jaimealbapastor/autonomous-gardener/Reports/Jaime/session03.md

***[<< previous session](session02.md) | [next session >>](session04.md)***

# Session 3

This session was dedicated to the modeling of the suspension pieces. My intention was to complete two or three, but it took longer than expected.

Since the wide bearing was delivered, I adjusted some measurements in Fusion360.
This one will be placed in the center of the differential.  
However, we are currently awaiting the delivery of the remaining bearings so that I can precisely measure them.
Then I'll 3D print these parts.

## Piece S1 (Suspension 1) - The differential

Here's how the differential currently looks like :

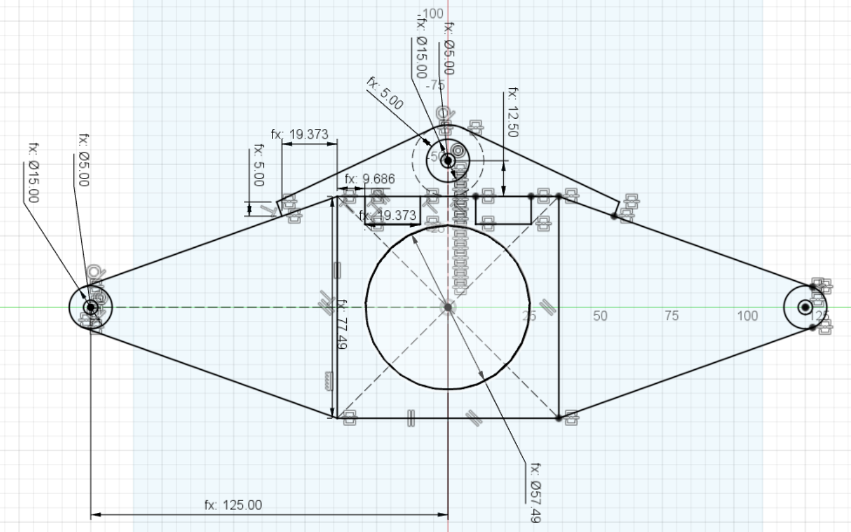
[picture p53: Documentation/Images/differential_sketch2.png]
differential_sketch2
||
|:---:|
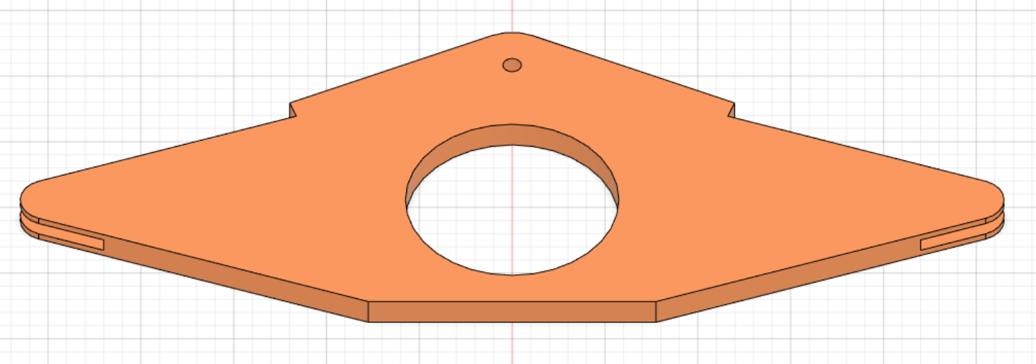
[picture p54: Documentation/Images/differential_3D_model_3.png]
3D_model_3
||
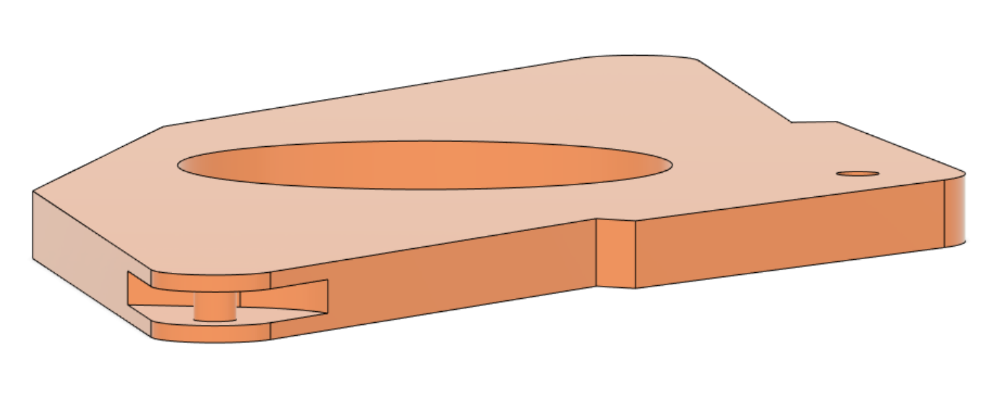
[picture p55: Documentation/Images/differential_3D_model_2.png]
3D_model_2
||

## Piece S2 (Suspension 2)

The branch linking the differential to the primary pivot is the next component to model. It will be named S2. As you can see, this is how it would look like :

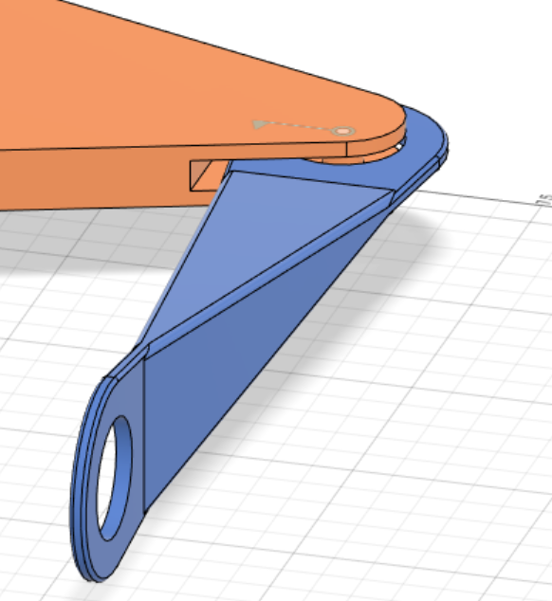
[picture p56: Documentation/Images/branch_assembly1.png]
branch_assembly1
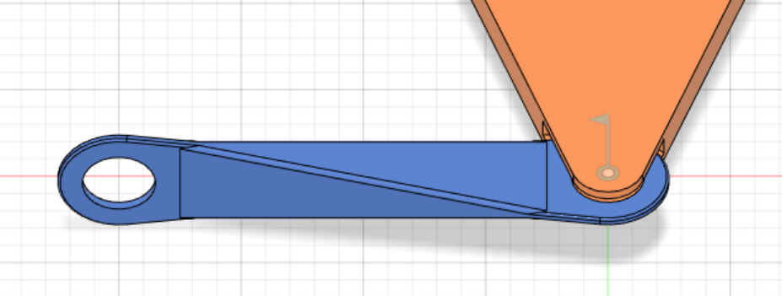
[picture p57: Documentation/Images/branch_assembly2.png]
branch_assembly2
|||
|:---:|:---:|
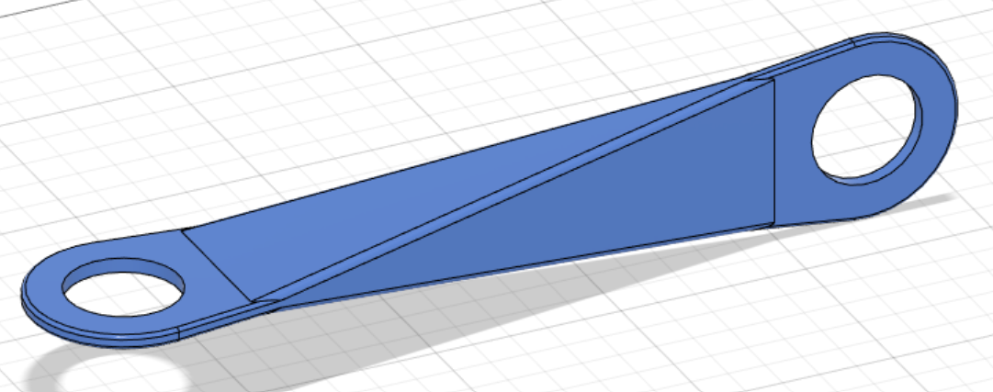
[picture p58: Documentation/Images/branch_model1.png]
branch_model1
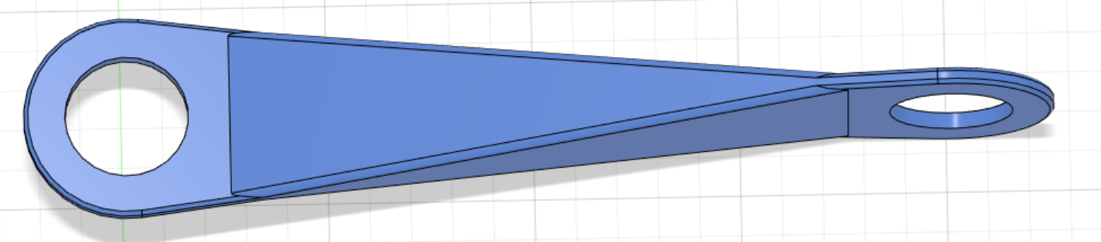
[picture p59: Documentation/Images/branch_model2.png]
branch_model2
|||

### Modeling

I initially tried modeling this component exclusively with extrusions. However, due to its peculiar geometry, it proved to be an inadequate solution.  

But after asking for advice, it ocurred to me that I could cut triangular shapes off the sides of a extruded rectangle.

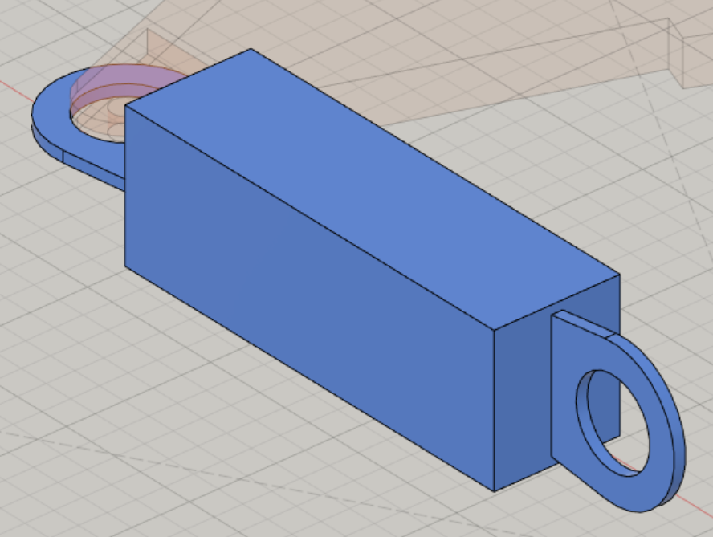
[picture p60: Documentation/Images/branch_model3.png]
branch_model3
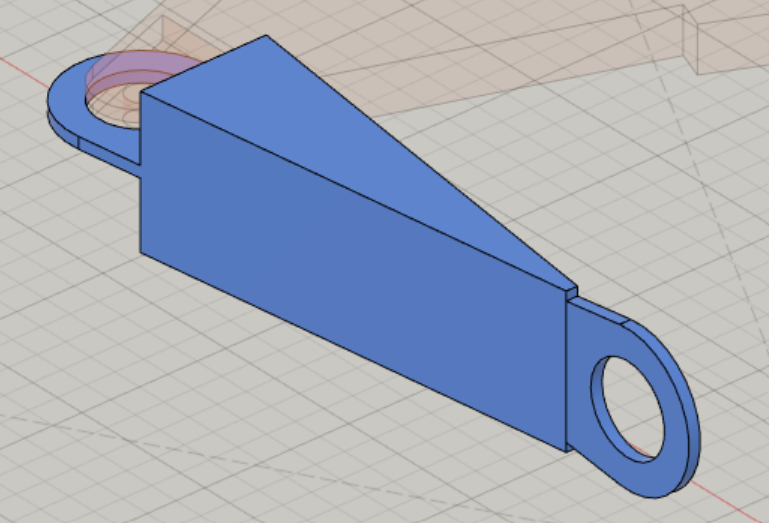
[picture p61: Documentation/Images/branch_model4.png]
branch_model4
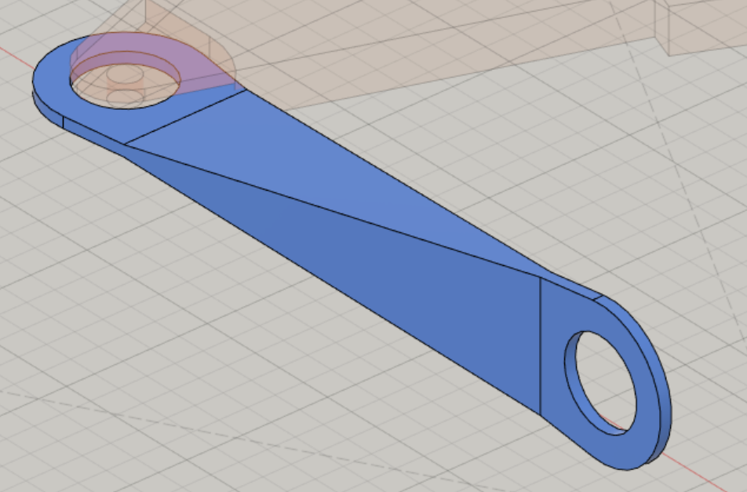
[picture p62: Documentation/Images/branch_model5.png]
branch_model5
||||
|:---:|:---:|:---:|

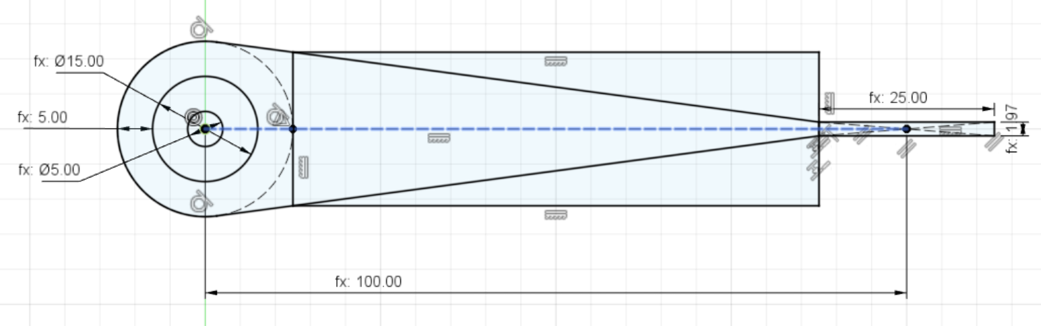
[picture p63: Documentation/Images/branch_sketch1.png]
branch_assembly1
||
|:---:|

***[<< previous session](session02.md) | [next session >>](session04.md)***
