jaimealbapastor/autonomous-gardener/Reports/Jaime/session04.md

***[<< previous session](session03.md) | [next session >>](session05.md)***

# Session 4

During this session I received the pipes and bearings for the differential.  
Here are the specifications:

|Pipes||
|:---:|:---:|
|External diameter|12 mm|
|Width|1 mm|

|Small Bearings|[Amazon.fr](https://www.amazon.fr/Roulements-Bearings-Skateboard-Longboard-Waveboard/dp/B07S3SZZST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)|
|:---:|:---:|
|External diameter|22 mm|
|Internal diameter|8 mm|
|Height|7 mm|

|Big Bearing||
|:---:|:---:|
|External diameter|57.5 mm|
|Internal diameter|50 mm|
|Height|7 mm|

Having the specifications of these two components, I updated the variables of the differential.

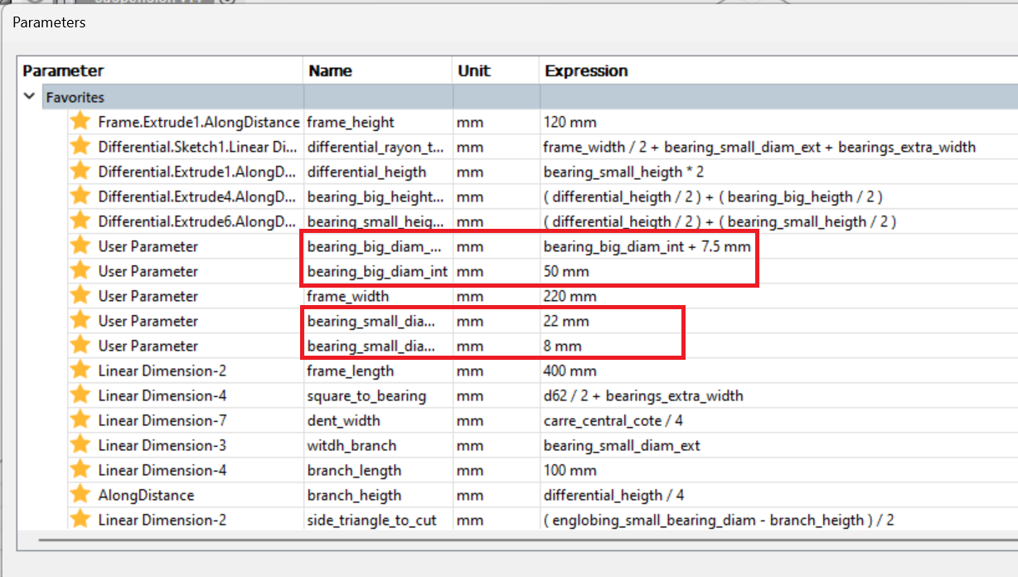
[picture p64: Documentation/Images/variables.png]
variables


I also made some little modifications to fit the bearings.

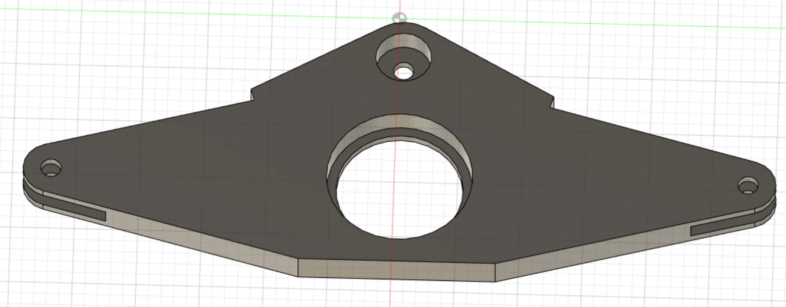
[picture p65: Documentation/Images/differential_3D_model_4.png]
differential_3D_model_4

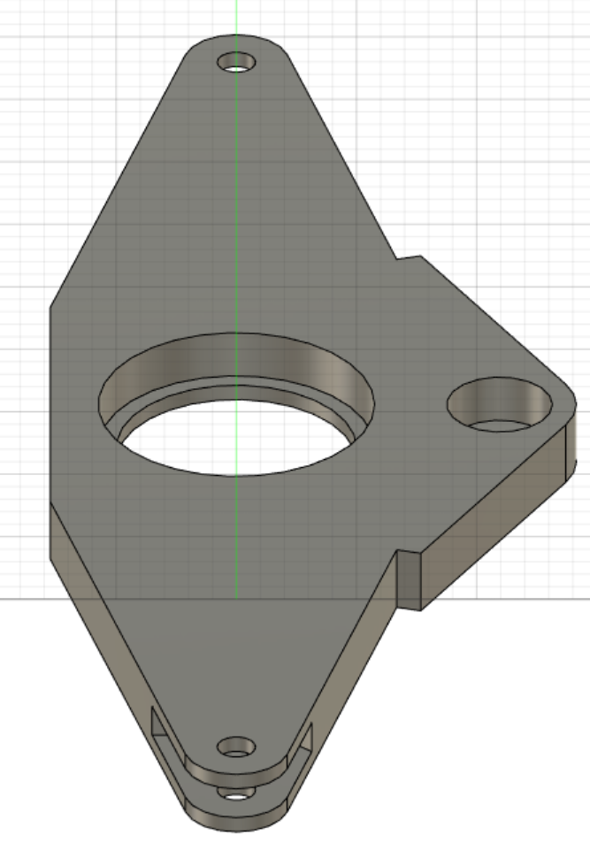
[picture p66: Documentation/Images/differential_3D_model_5.png]
differential_3D_model_5


Plus, in order to optimize the [piece S2](./session3.md/#piece-s2-suspension-2), I remodeled it using the pipes.

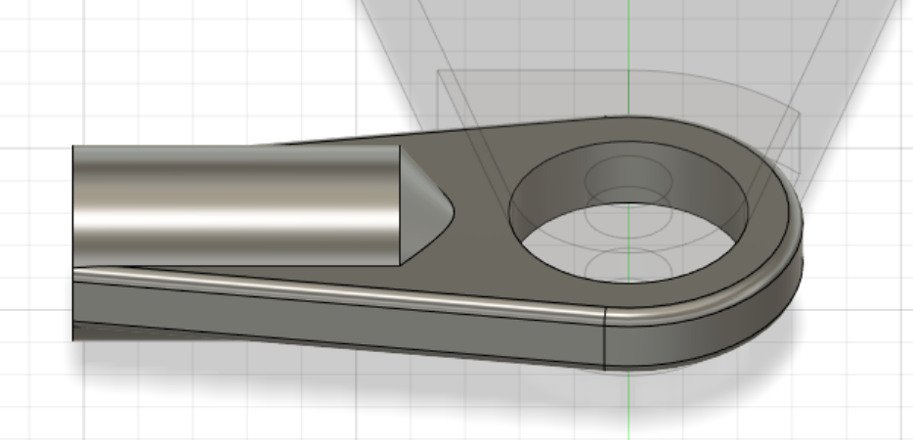
[picture p67: Documentation/Images/S2_1.png]
S2_1

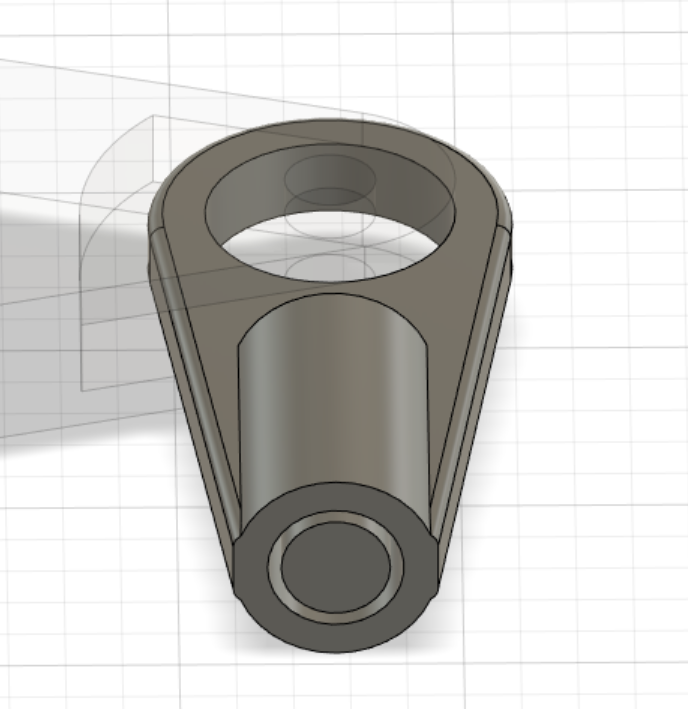
[picture p68: Documentation/Images/S2_2.png]
S2_2

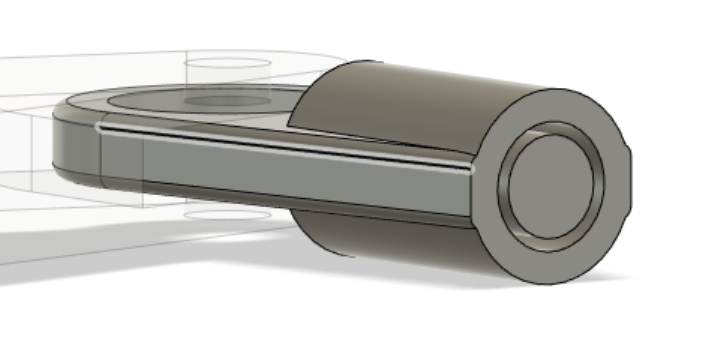
[picture p69: Documentation/Images/S2_3.png]
S2_3


## Fabrication

In order to 3D-print the differential, I sliced the 3D model and exported the G-code.  
However, after a quick discussion with M.Masson, we decided that making it out of wood would be preferable in case we needed to make minor changes to the piece.  

To make it out of wood, I'll laser-cut multiple layers and glue them all together. As a result, the differential will be both rigid and light.  
So I began by exporting the Fusion360 sketch to create the svg file, but the exported file is not optimized for editing in Inkscape.  

As a result, my next session will be devoted to:  

1. Recreate the sketch so that it can be exported and edited as an svg file.  
2. 3D-print the piece S2

---
Note  
[*S'inscrire au GDR*](https://www.gdr-robotique.org/inscription/)

***[<< previous session](session03.md) | [next session >>](session05.md)***
