jaimealbapastor/autonomous-gardener/Reports/Jaime/session06.md

***[<< previous session](session05.md) | [next session >>](session07.md)***

# Session 6

## Differential production

I created the initial version of the differential during the brief session we had with M. Masson at the FabLab. But because of a measurement error, I had to start over throughout this session.

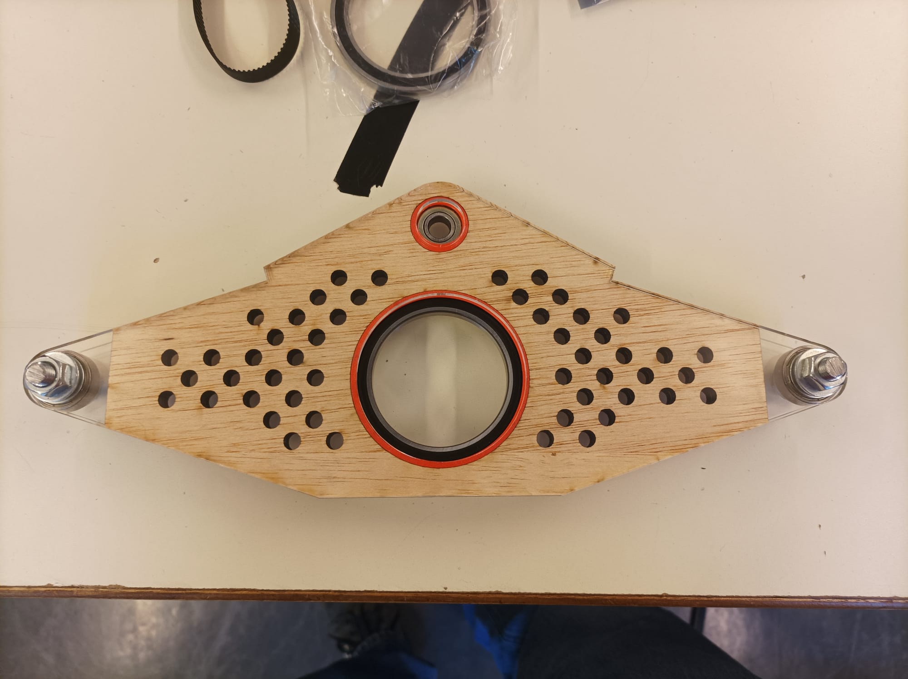
[picture p79: Documentation/Images/differential_built_2.jpg]


I started by cutting the inner layers of the differential, which are made out of wood, with the laser cutter. These two 5mm layers, which make up a total of 10mm, encircle the middle bearings and attenuate minor vibrations.

Then, the rigidity of the differential will then be handled by the plexiglass outer layers.

The bearings can rotate without encountering any resistance through 3D printed rings that separate the bearings in the wood layer from the plexiglass.

Finally, I sawed a threaded tube that holds the bearing and layers of plexiglass together. Rings are also mounted to the bearings to reduce friction with the plexiglass layers.

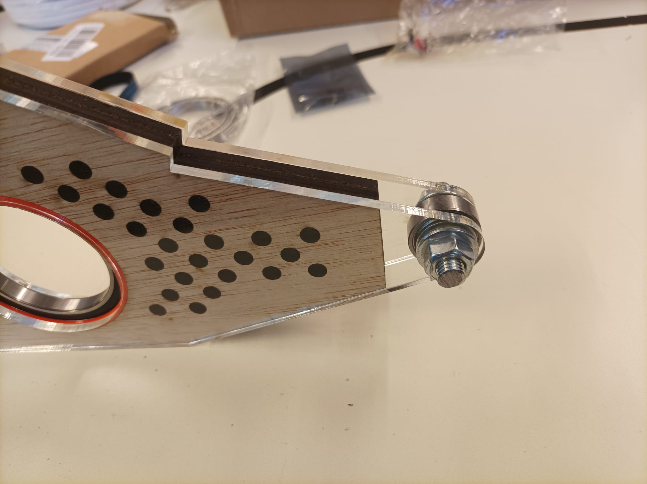
[picture p80: Documentation/Images/differential_built_1.jpg]


The tube joint below will be supported by the bearings on the extremities.  
Nevertheless, the printed version's diameter was too small for our tube. Therefore, I've started a 3D impression for a different version that hopefully meets the requirements.

|||
|:---:|:---:|

## Main pivot

I've started modelling the main pivot in order to add wheels as soon as possible.

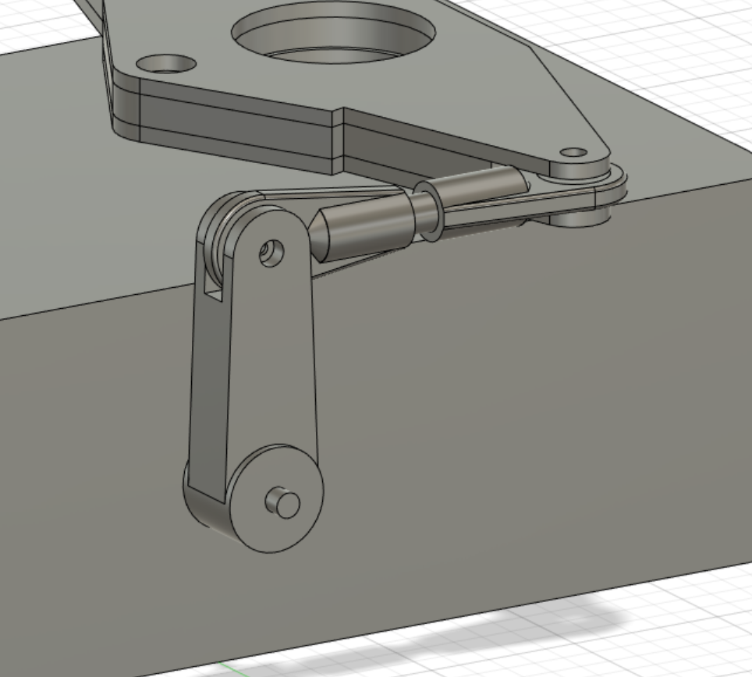
[picture p81: Documentation/Images/main_pivot_1.png]
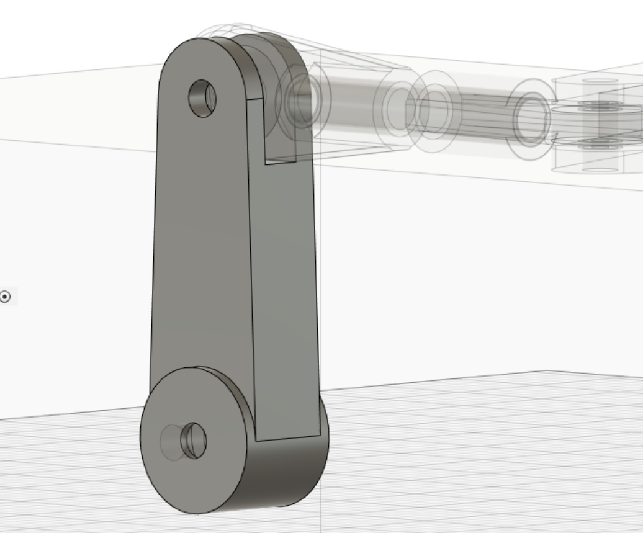
[picture p82: Documentation/Images/main_pivot_2.png]
|||
|:---:|:---:|

This piece wont be using metal tubes since the distance is pretty short. However, in the case where the robot was made bigger, I would redesign the main pivot.

Inside the piece will be located two bearings as such:



However, I'm still considering whether to put them inside or make them visible so that we may remove them whenever we want.  

Finally, I am facing difficulties extruding the other tube joints. I'm trying to make them angled like the mars rover, but if it takes too long, I might just make them straight.

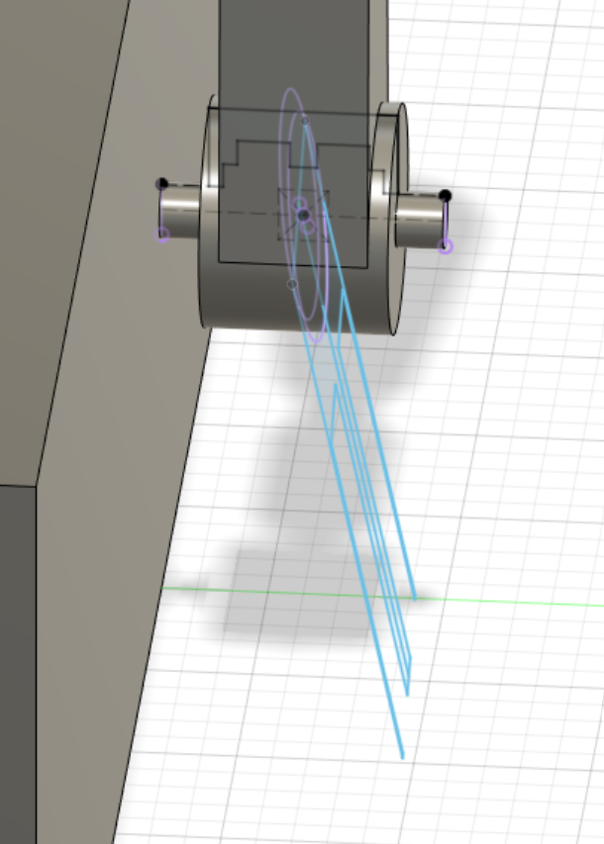
[picture p83: Documentation/Images/main_pivot_4.png]


***[<< previous session](session05.md) | [next session >>](session07.md)***
