jaimealbapastor/autonomous-gardener/Reports/Jaime/session07.md

***[<< previous session](session06.md) | [next session >>](session08.md)***

# Session 7

## Differential

During this session I finished the building of the differential.

The new version of the 3d printed joints that will connect to the tubes fit perfectly.

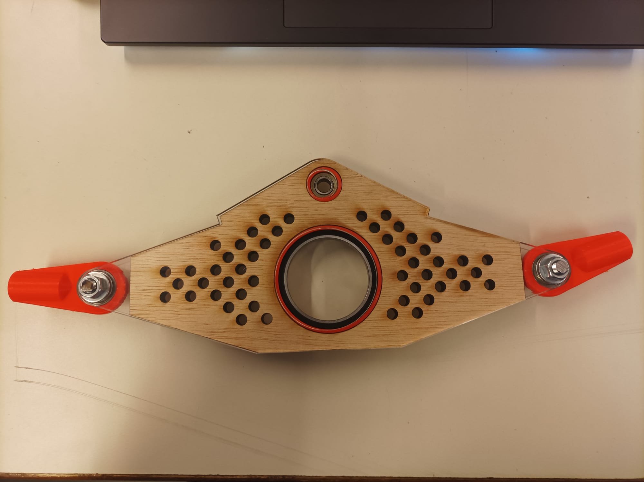
[picture p84: Documentation/Images/differential_built_3.jpg]
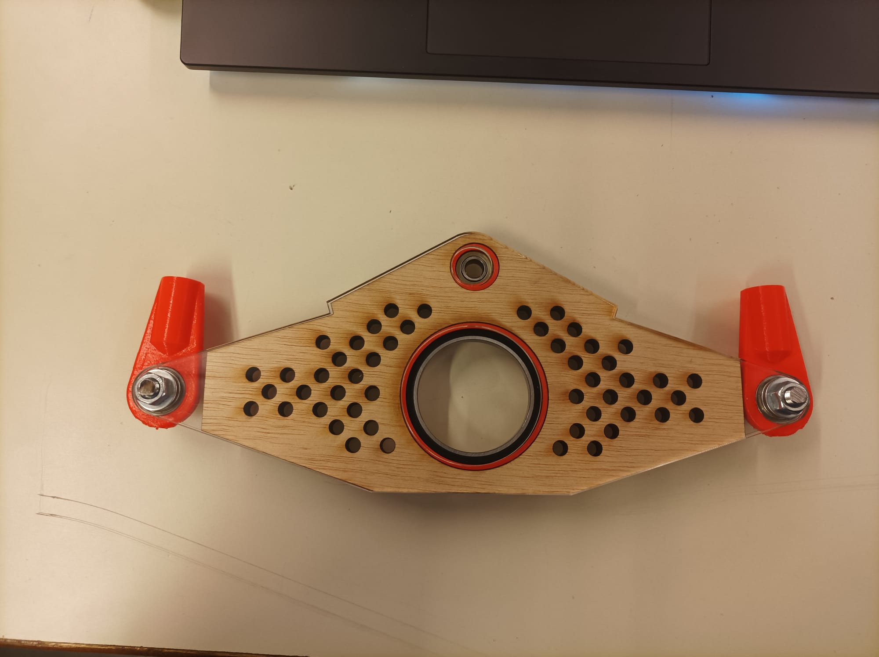
[picture p85: Documentation/Images/differential_built_4.jpg]
|||
|:---:|:---:|

Additionally, I drilled several holes so that I could add screws and keep the wood layer in place.

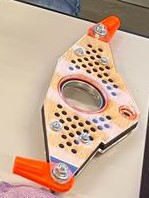
[picture p86: Documentation/Images/differential_built_5.jpg]


I discovered a minor problem: the bearings inside the wood layer are a little loose. So I'll just print new 3D rings a bit wider.

## Main pivot

I continued modeling the main pivot.  

The component will have to withstand significant angular forces coming from the tubes to the vertical axe. So, in order to increase the distribution of the momentum, I modelled a circular shape.

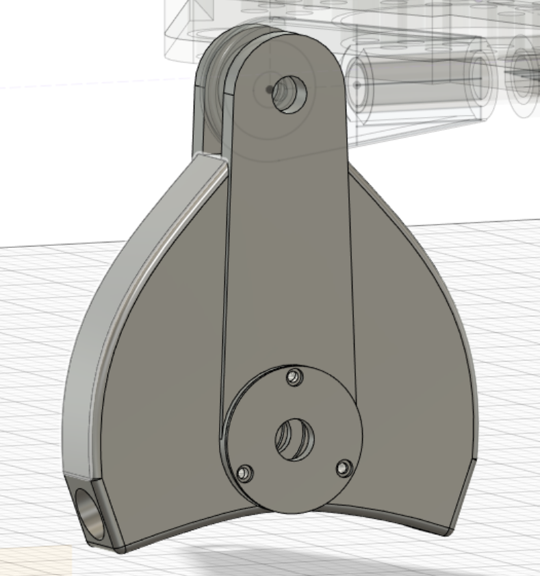
[picture p87: Documentation/Images/main_pivot_5.png]
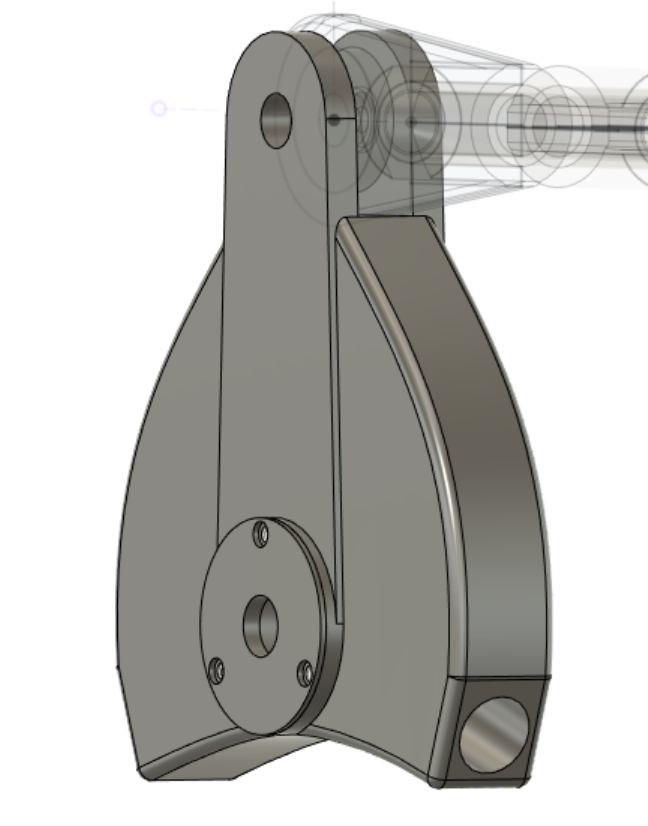
[picture p88: Documentation/Images/main_pivot_6.png]
|||
|:---:|:---:|

However, I believe that applying the Trellis approach would help to reduce the mass. I'll investigate that over the weekend.  

Finally, I placed two lids to the piece's sides so that the bearings can be taken out if necessary.  

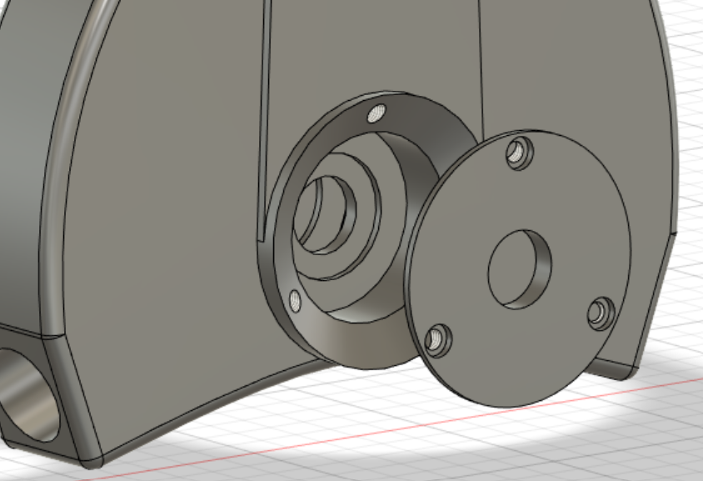
[picture p89: Documentation/Images/main_pivot_7.png]
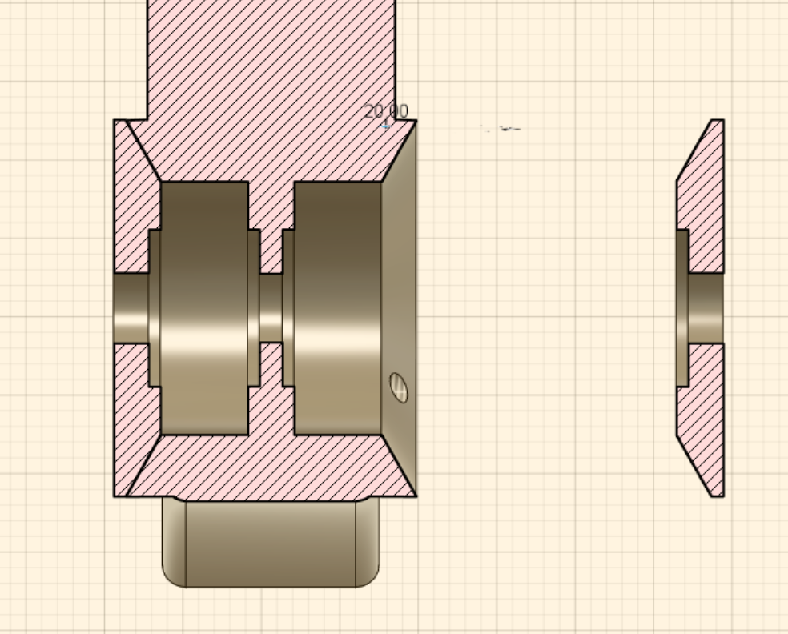
[picture p90: Documentation/Images/main_pivot_8.png]
|||
|:---:|:---:|

***[<< previous session](session06.md) | [next session >>](session08.md)***
