jaimealbapastor/autonomous-gardener/Reports/Jaime/session09.md

***[<< previous session](session08.md) | [next session >>](session10.md)***

# Session 9

I first started this session by taking the finished 3d impression of the main pivot.  
I had to take away all the supports which take a long time.

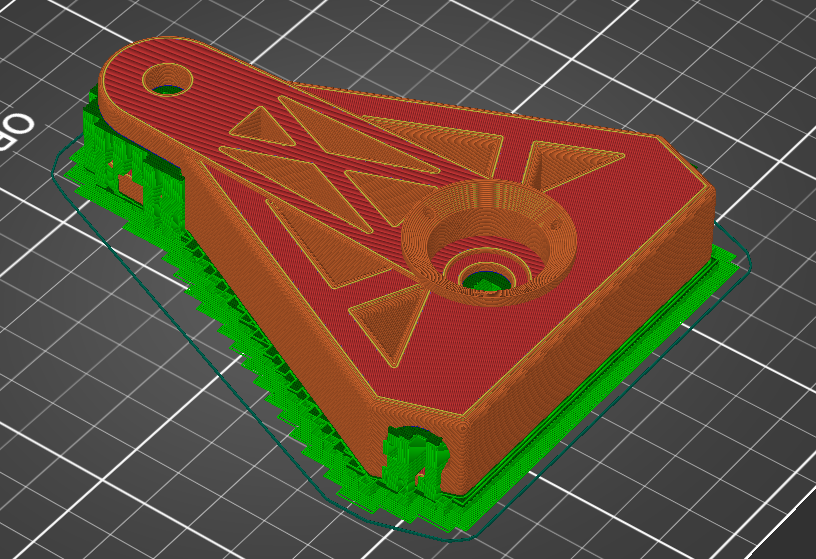
[picture p91: Documentation/Images/main_pivot_14.png]

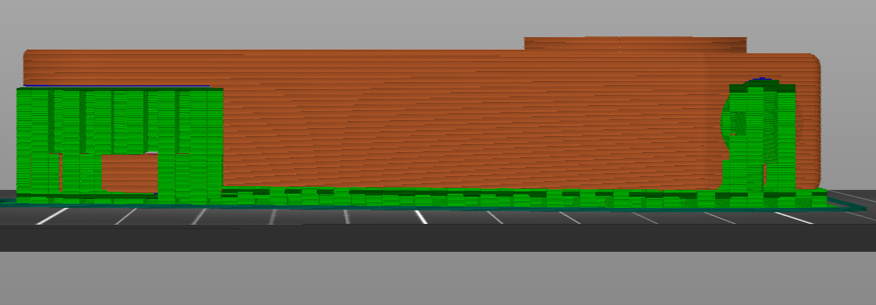
[picture p92: Documentation/Images/main_pivot_15.png]


Then I softened the borders and faces.

I had to make the thread for the screws in order to fix the bearings inside. This was a really slow and focused activity.

Brice assisted me in inserting the tube through the main axe after this was finished and the bearings were secured internally. We used a heavy hammer to smash our way in.

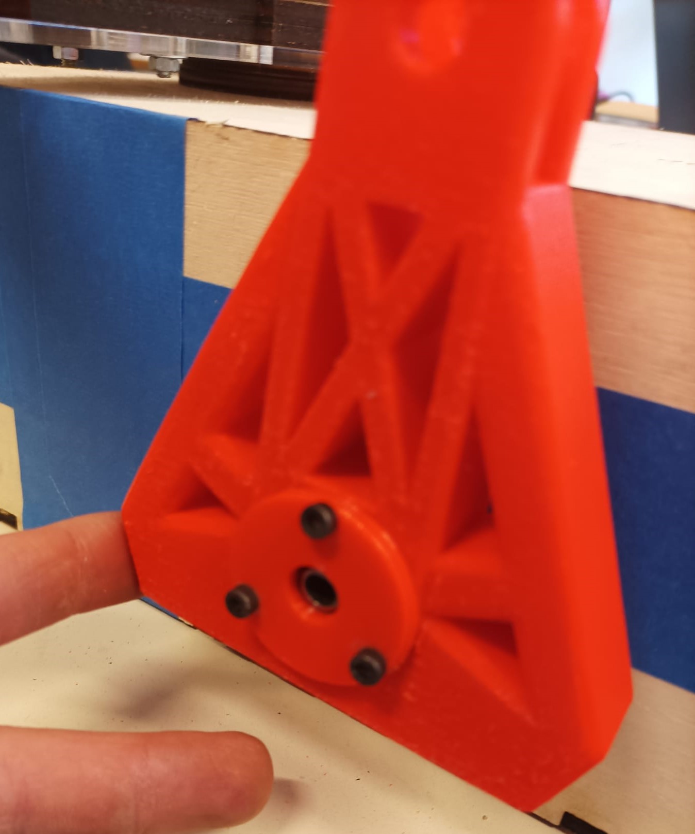
[picture p93: Documentation/Images/main_pivot_impression_1.jpg]

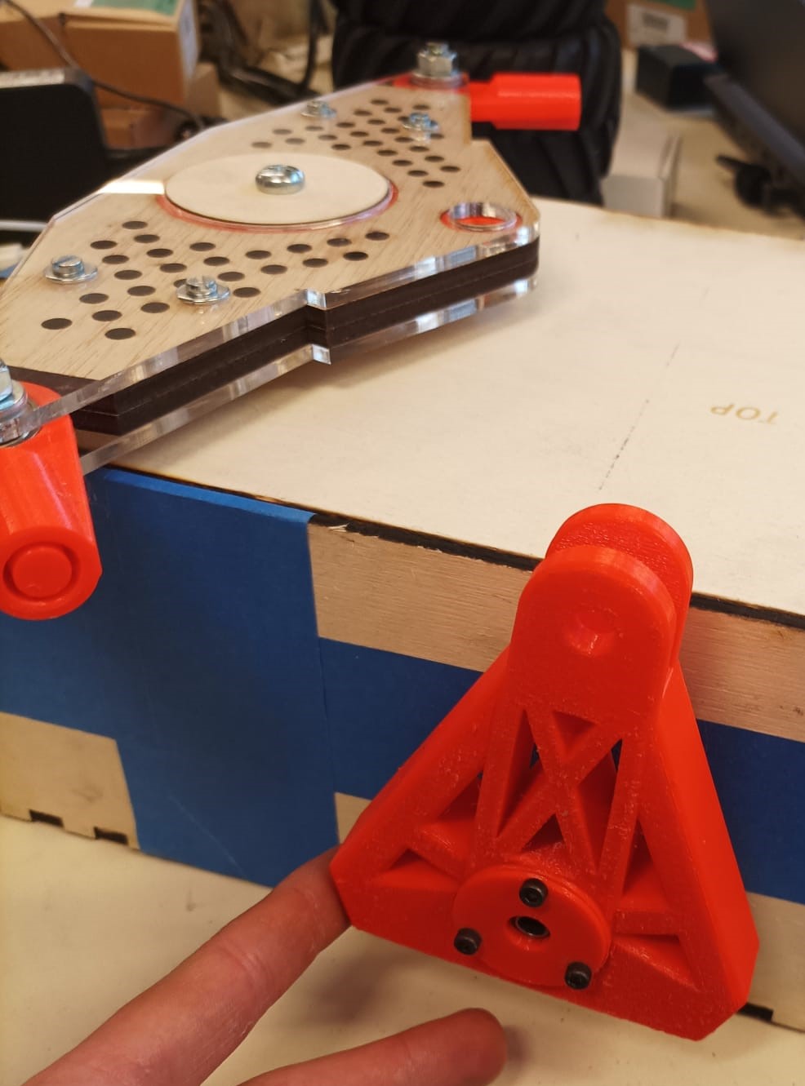
[picture p94: Documentation/Images/main_pivot_impression_2.jpg]
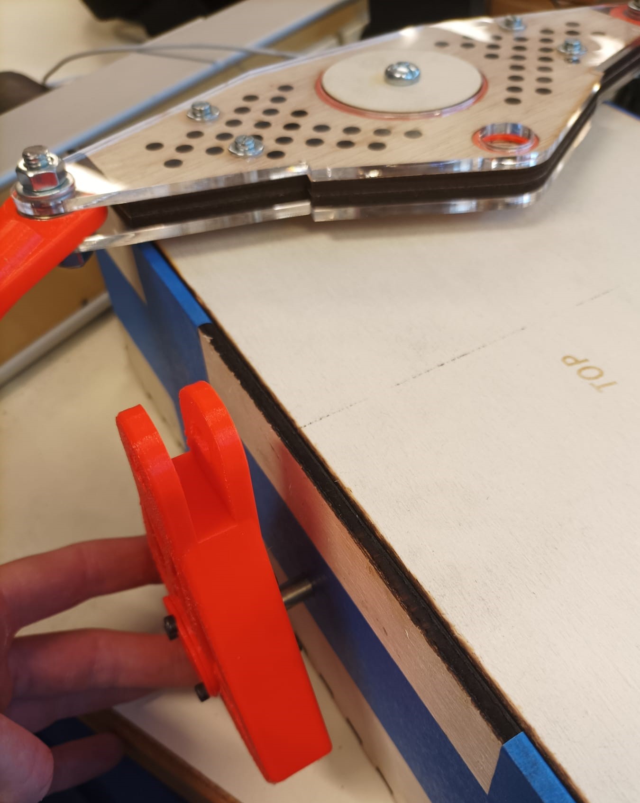
[picture p95: Documentation/Images/main_pivot_impression_3.jpg]
|||
|:---:|:---:|

By the end of the session, I noticed that the tubes connecting the wheels weren't the right size. I therefore had to even them out. They now fit flawlessly.

Brice and I also talked about how to attach the differential to the frame. We made the decision to laser cut the wood into circular shapes to encircle the central bearing. By doing so, we prevent friction.

In order to prevent the frame from collapsing, I additionally applied scotch tape to it.

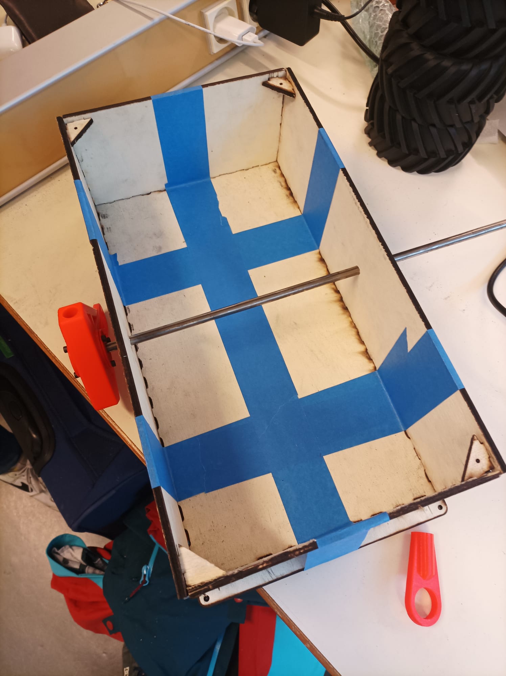
[picture p96: Documentation/Images/frame1.jpg]


***[<< previous session](session08.md) | [next session >>](session10.md)***
