jaimealbapastor/autonomous-gardener/Reports/Jaime/session13.md

***[<< previous session](session12.md) | [next session >>](session14.md)***

# Session 13

Powering the motors and verifying the `C++` code should be the next steps in the project.
But since the drivers weren't there yet, I carried on enhancing the mechanical structure.

I took the 3D printed parts out of the printer and spent the first hour carefully removing the supports.  

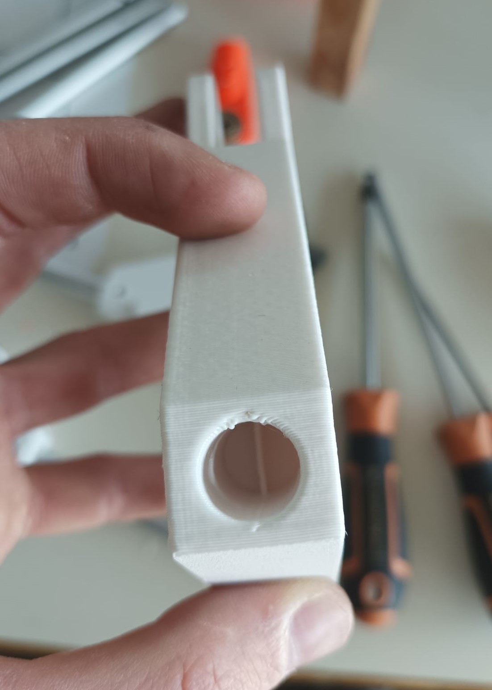
[picture p108: Documentation/Images/piece1.jpg]
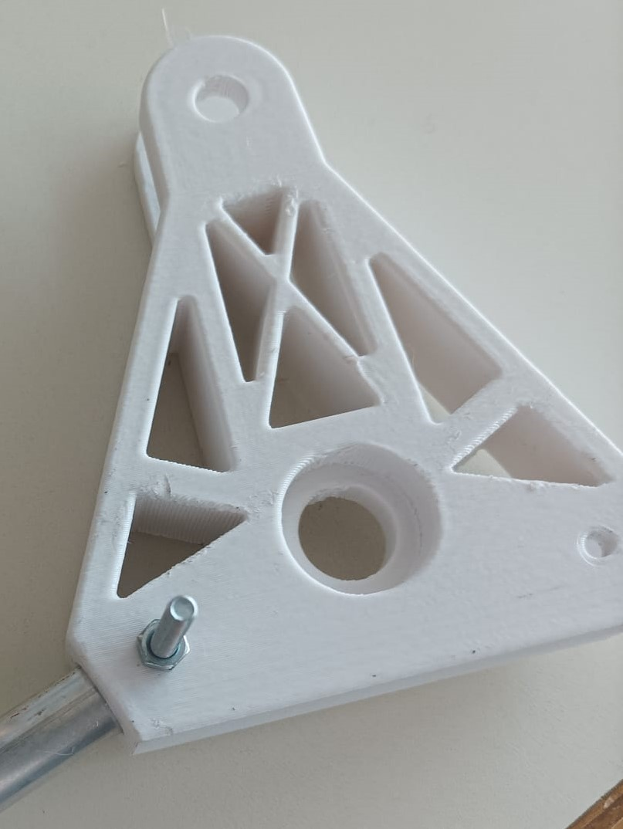
[picture p109: Documentation/Images/piece2.jpg]
|||
|:---:|:---:|

To make the components fit together in this new design, I must cut a thin stripe.

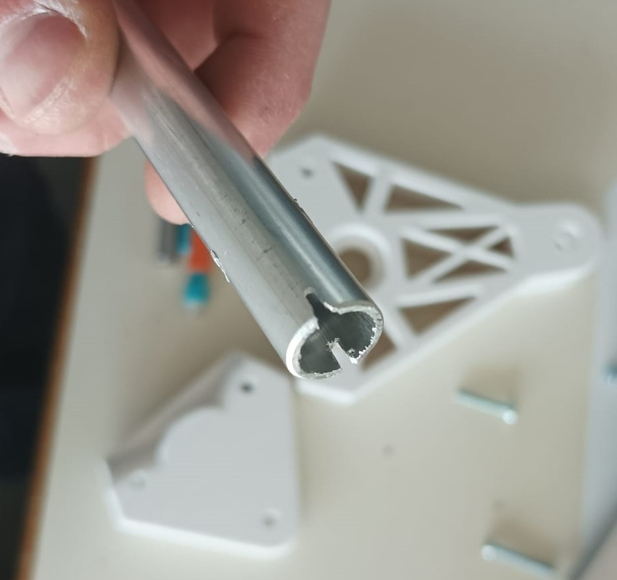
[picture p110: Documentation/Images/piece4.jpg]
  

I achieved what I was aiming for by giving the tubes almost no freedom of movement.  
Also, since the 3D printed parts already have holes, drilling the tubes is so much faster and more accurate.

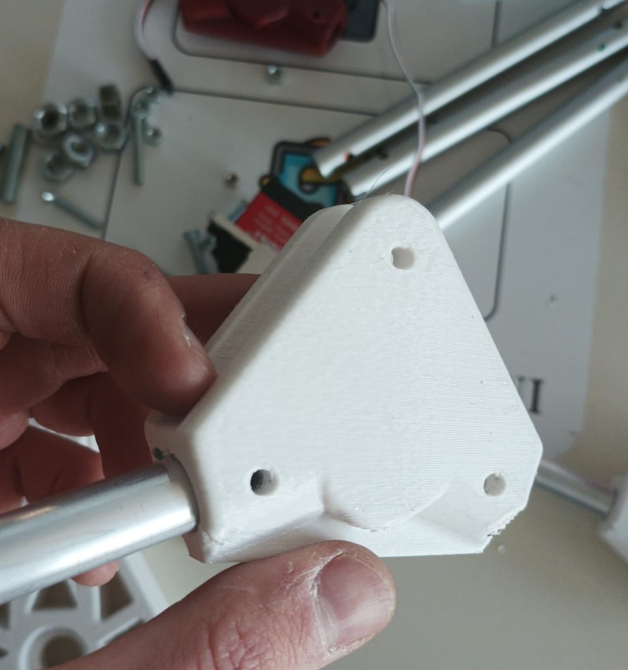
[picture p111: Documentation/Images/piece3.jpg]
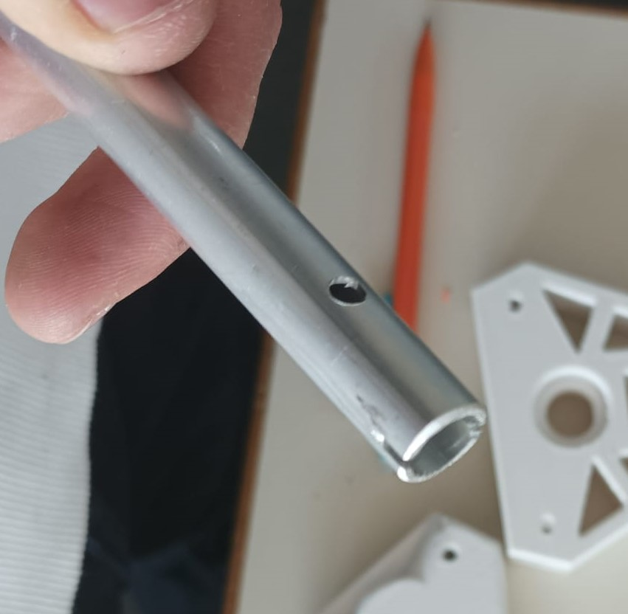
[picture p112: Documentation/Images/piece5.jpg]
|||
|:---:|:---:|

I prioritized the precision over the speed, so I only had time to finish one side of the structure. Due to the lengthy and slow process, this session report has less information.

Nonetheless, this work should greatly improve fluidity and decrease future crashes.  

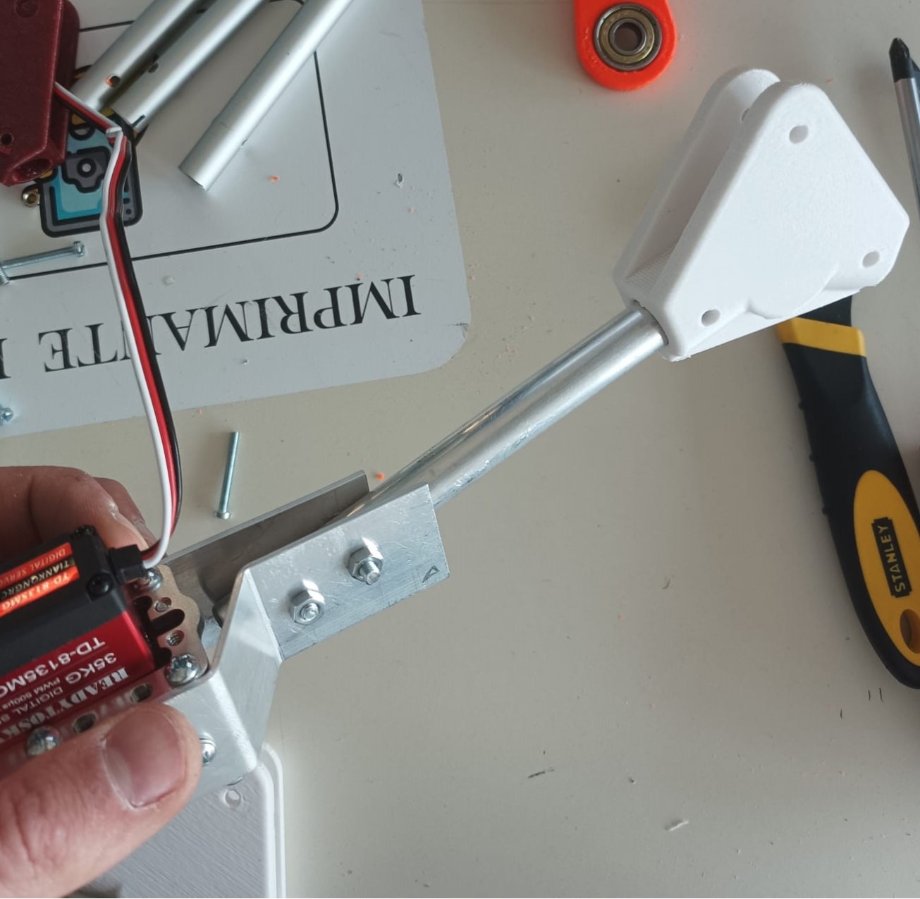
[picture p113: Documentation/Images/piece6.jpg]
  

***[<< previous session](session12.md) | [next session >>](session14.md)***
