jaimealbapastor/autonomous-gardener/Reports/Jaime/rapport_info.md

premier jour

idéation du code et angles roues

deuxieme jour

probleme ssh windows
https://unix.stackexchange.com/questions/602518/ssh-connection-client-loop-send-disconnect-broken-pipe-or-connection-reset

sur virtualbox ça marche via serial

connexion à wifi sur tel (2.4GHz)
puis connexion ssh sur windows

`ifconfig` pour voir les addresses IP

pour le moment serial mais on passera surement à I2C pour connecter le lidar à la jetson nano directement

communication python et arduino
https://www.instructables.com/Arduino-Python-Communication-via-USB/
