jaimealbapastor/autonomous-gardener/Reports/Brice/Séance 6.md

## Rapports de séance Brice Mabille

- 06/12/2022 : Setup du projet GitHub partagé

# Séance 6:

In this session, I started by 3D printing the Auger and the gear system.

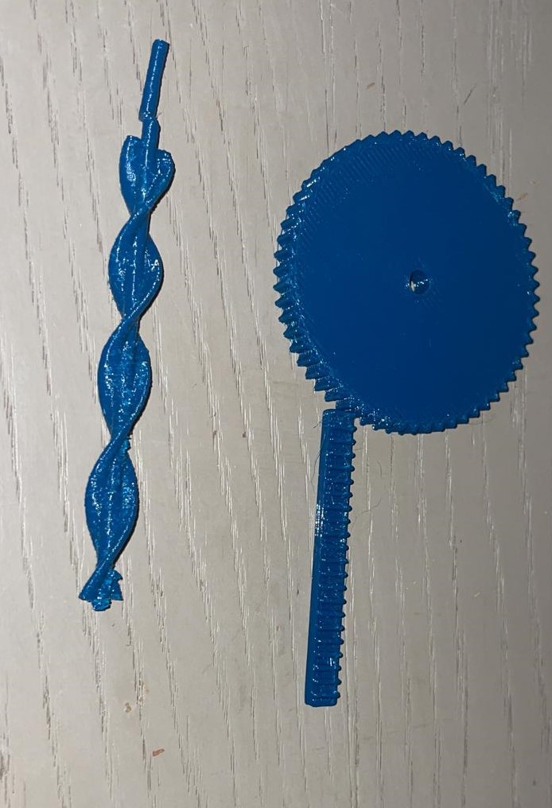
[picture p153: Documentation/Images/Auger+drill-fail.jpeg]


Sadly, I wasn't entirely certain about the dimension, thus it was a first attempt. I watched it since the outcome was too meager and insufficient for drilling into the floor.

So I adapted the dimension, the filling and I printed it again. This time the Auger was nice except the joint to link the Auger with the motor and the gear system had this issue too.

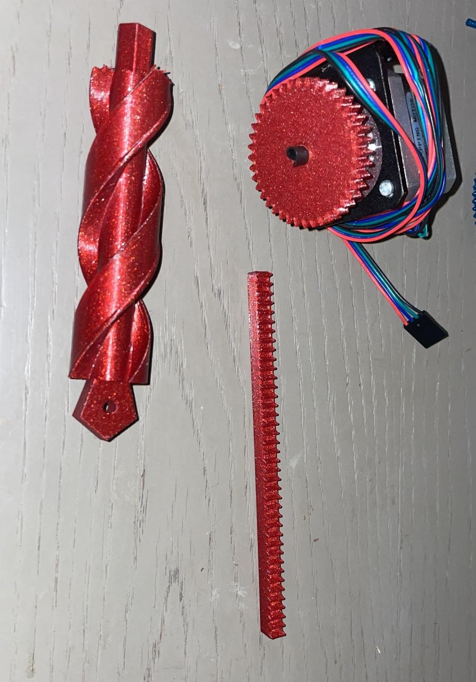
[picture p154: Documentation/Images/Auger+drillsuccess.jpeg]
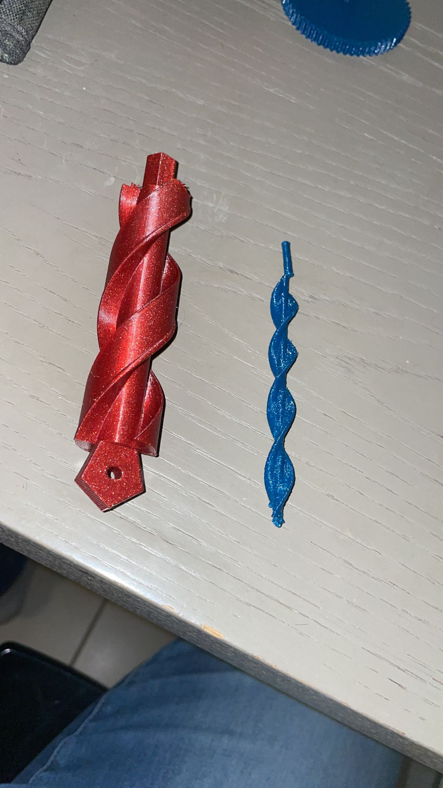
[picture p155: Documentation/Images/Augercompared.jpeg]
|||
|:---:|:---:|

With those prints, I modified the gear system model to include a holding device, which will enable the stepper to be properly maintained at this time.

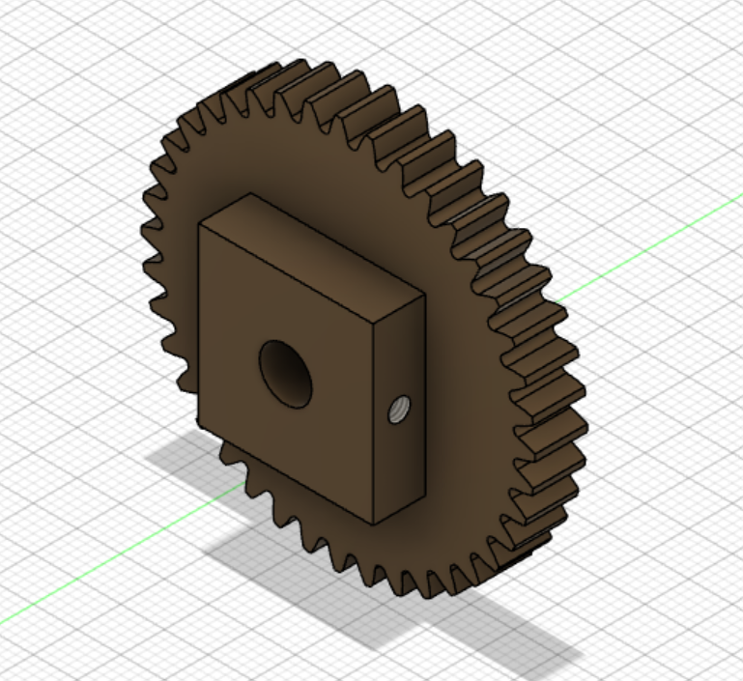
[picture p156: Documentation/Images/GEAREPAULEMENT.png]


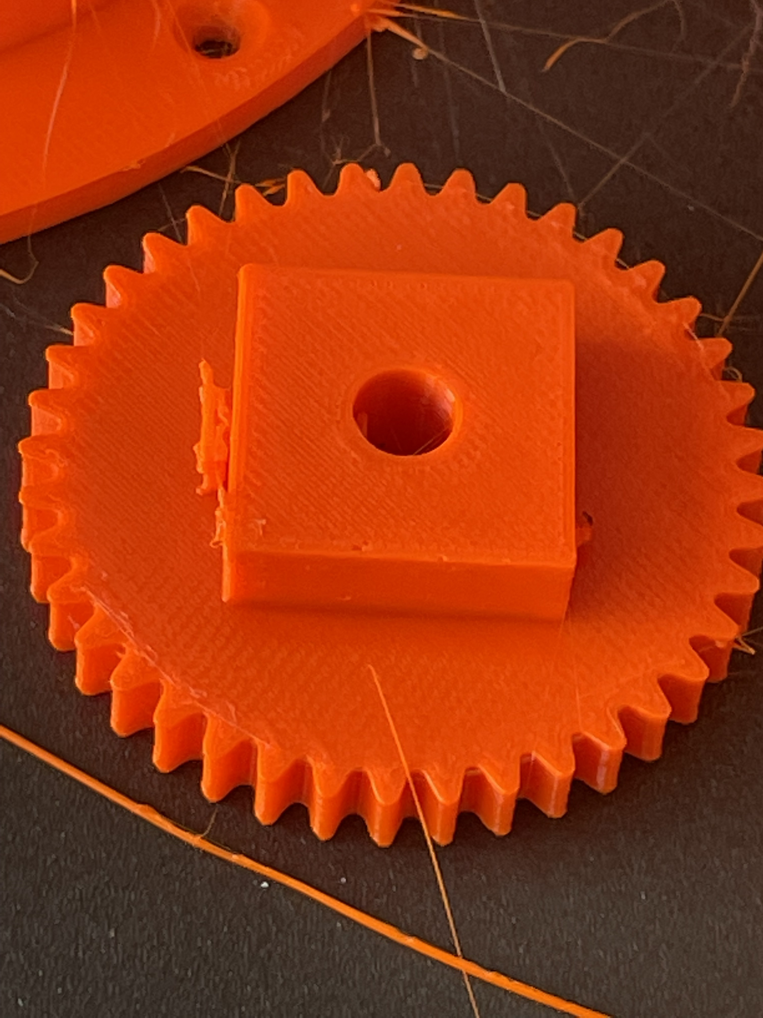
[picture p157: Documentation/Images/Gear+epaulement.jpg]


But for the Auger, I wanted to post-treat to insert it in the mandrel.

Second, with Frédéric Juan's assistance, we make a small hole in the mandrel and insert it into the motor.
It was a great idea but we believe that the Auger will not revolve properly.

Unfortunately, when I used the Auger to test the motor, I damaged it, making it impossible for me to determine whether the rotation was accurate.

However, it enables me to test the motor's operation.

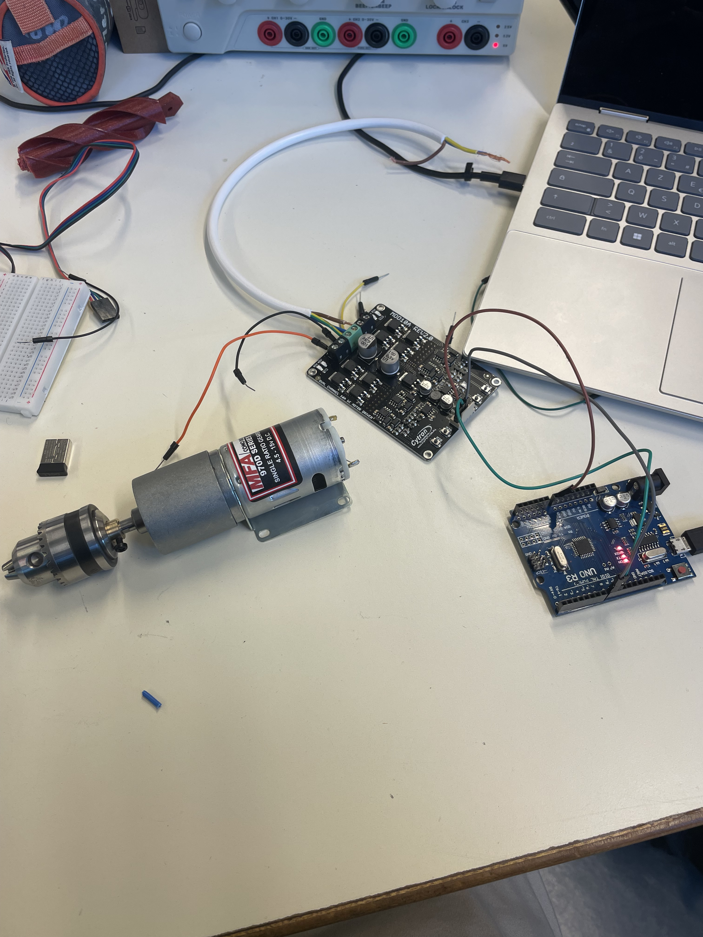
[picture p158: Documentation/Images/Motor+mandrel.jpg]


Furthermore, I researched the system Jaime and I had selected to model before I started the Lidar system.
When I watched the movie again, I saw that the author's modelization was available online on github, so I copied it and printed it.


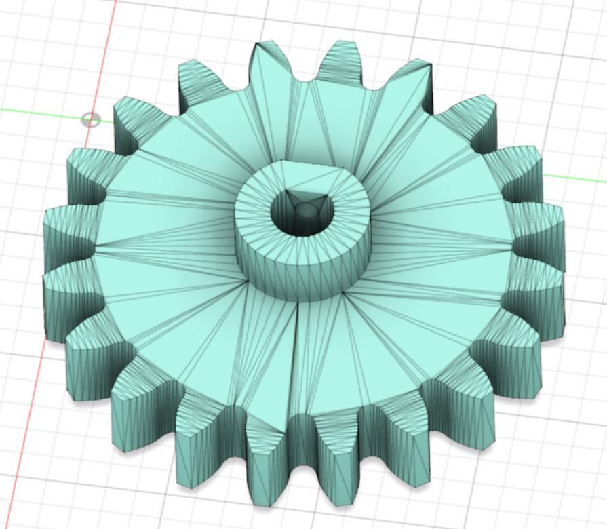
[picture p159: Documentation/Images/LIDAR2.png]

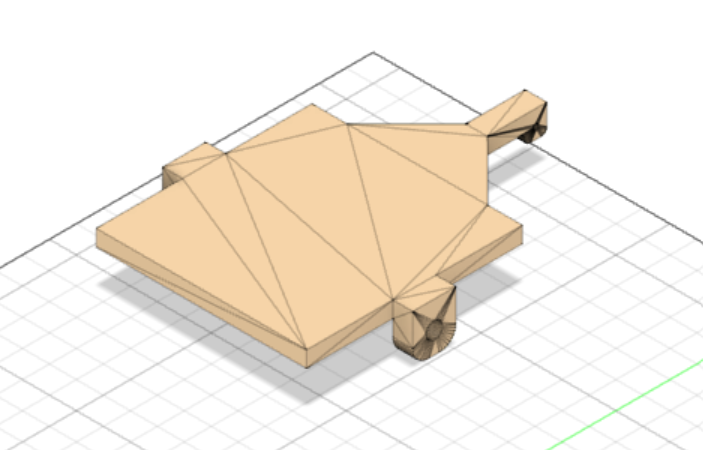
[picture p160: Documentation/Images/LIDAR3.png]

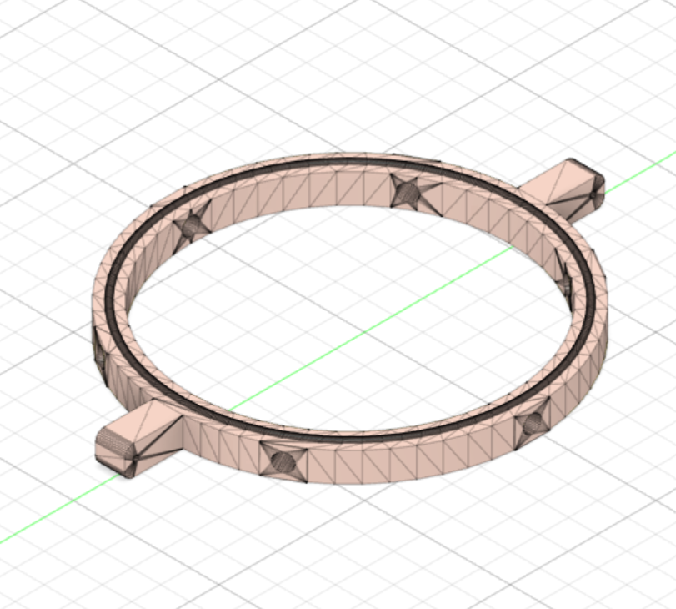
[picture p161: Documentation/Images/LIDAR4.png]

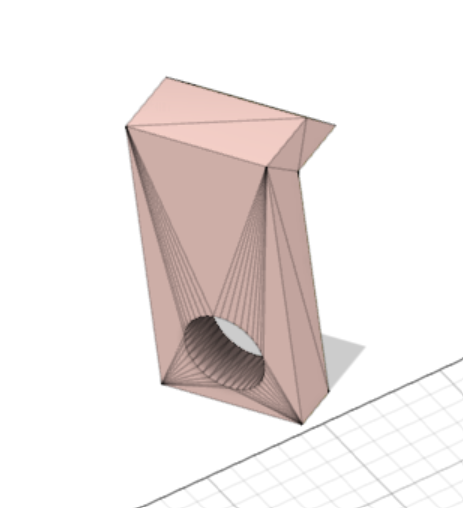
[picture p162: Documentation/Images/LIDAR5.png]

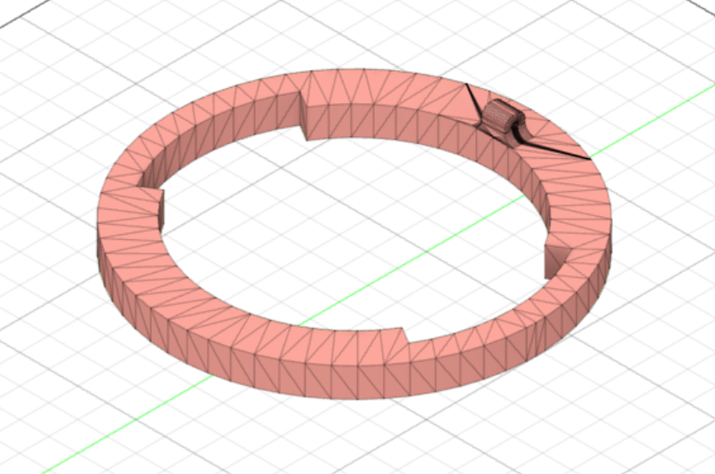
[picture p163: Documentation/Images/LIDAR6.png]

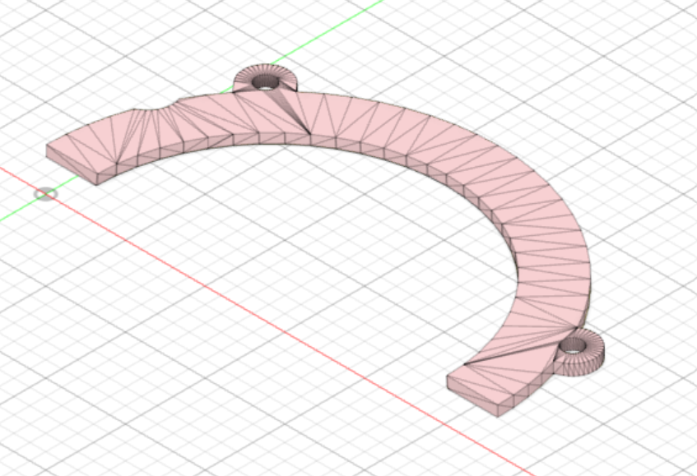
[picture p164: Documentation/Images/LIDAR7.png]

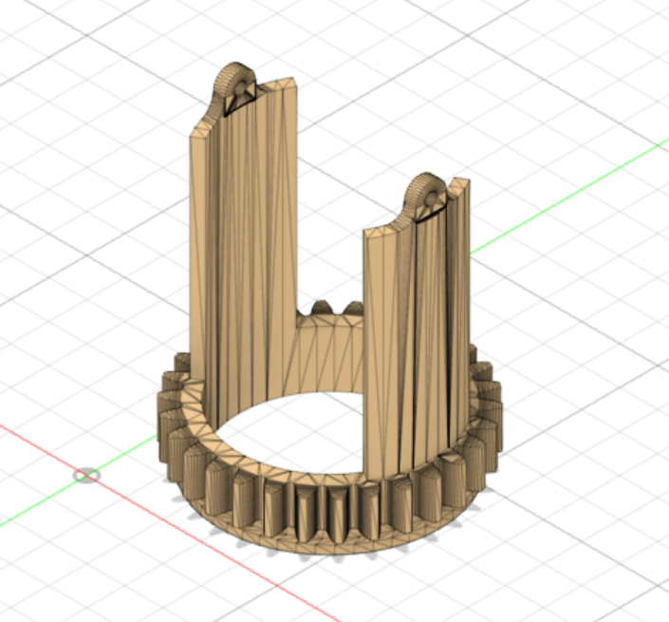
[picture p165: Documentation/Images/LIDAR8.png]

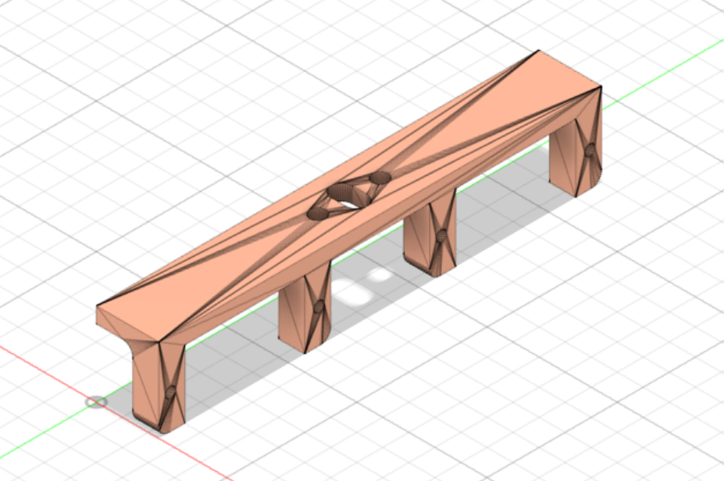
[picture p166: Documentation/Images/LIDAR9.png]

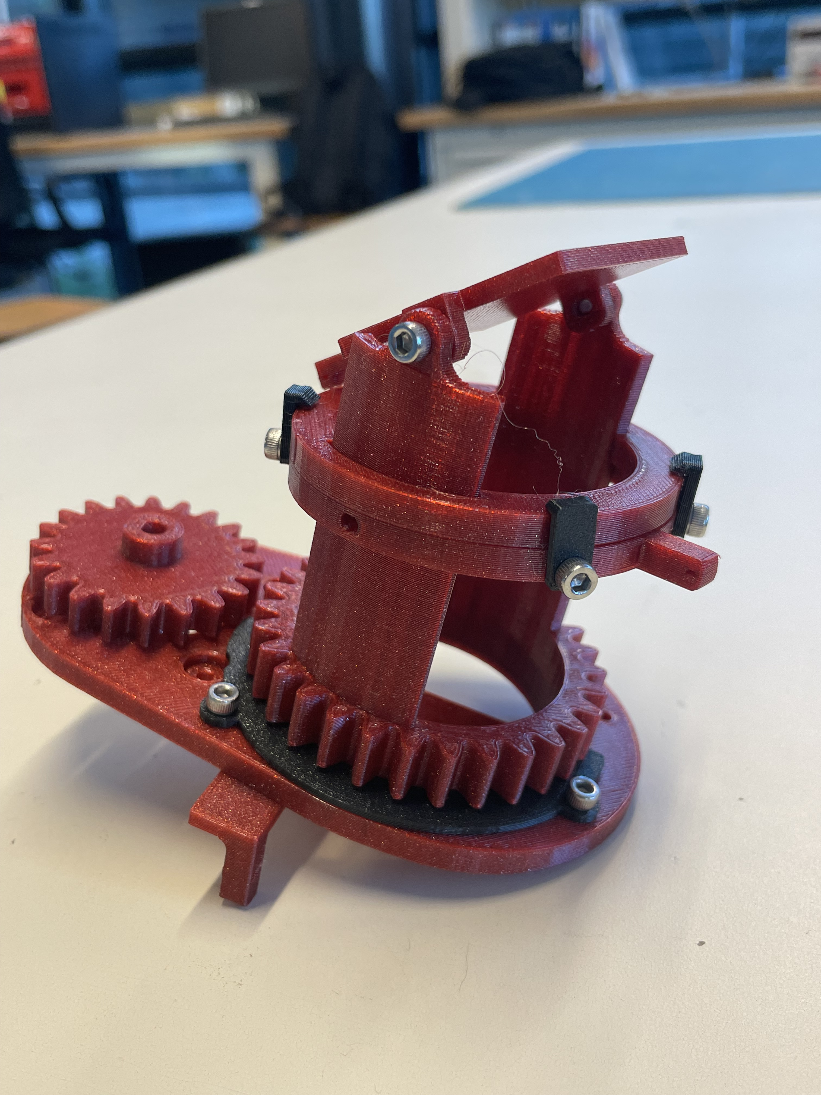
[picture p167: Documentation/Images/LIDAR.jpg]


Moreover, I had to use a laser cutter to cut the water and seed stock that I designed in Inkscape. I'll then assemble it with silicone to ensure proper sealing.

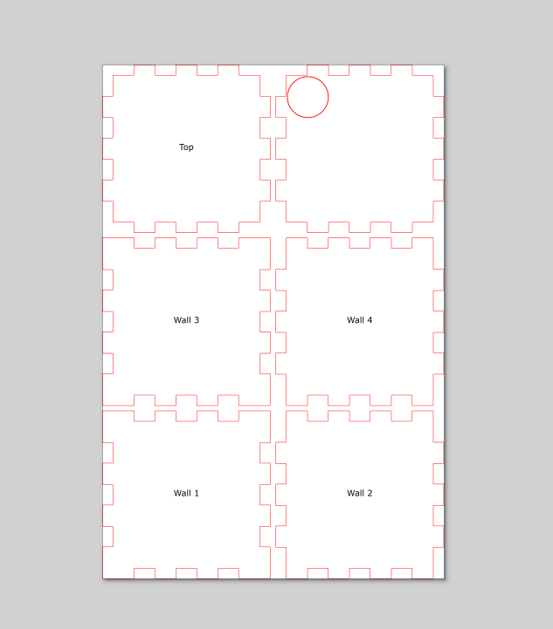
[picture p168: Documentation/Images/WaterSeedStock.png]


In order to observe how it functions, I finally put the stepper in operation with the gear and the rack. However, when I powered up the circuit, nothing happened, so I will try again at the following session.

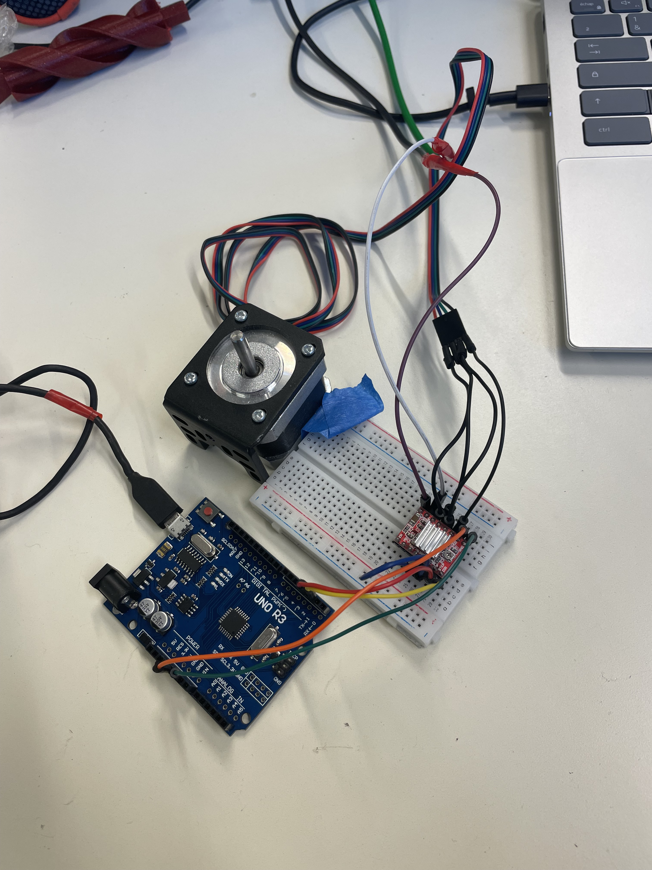
[picture p169: Documentation/Images/Steppercircuit.jpg]


I'll finish the drilling mechanism completely for the subsequent session and put it in the frame. And I'll keep using the Lidar, water, and seed supply.

BONUS: Goodies Creation for my Polytech presentation this week-end to promote the school and the Robotic speciality.

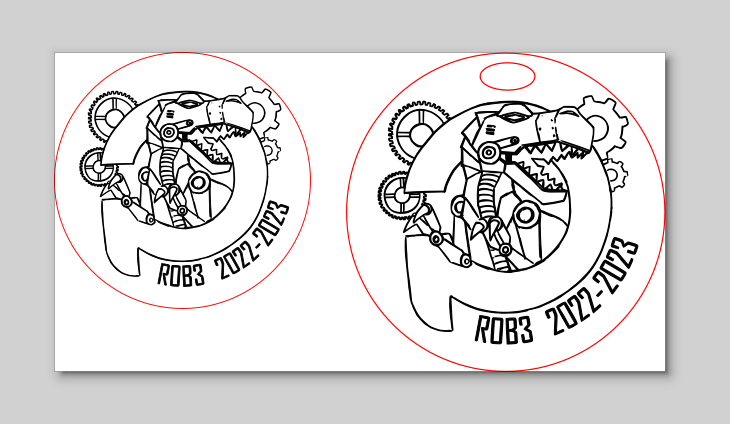
[picture p170: Documentation/Images/BonusGoodies.png]
