jaimealbapastor/autonomous-gardener/Documentation/GanttDiagram.pdf

# GANTT DIAGRAM

PROJECT NAME | E-Gaïa
PROJECT MANAGERS | Jaime, Brice | DATE | 13/09/22
NUMBER | TASK TITLE | | START
DATE | DUE DATE DURATION
| | | | | (days) | TASK PROGRESSION

PHASE ONE

| | WHO
10 Hours | 10 Hours | 10 Hours

### 1 Robot conception

1.1 | Robot ideas | Jaime Brice | 13/09/22 | 20/09/22 | 7 | 100 %
1.2 | Robot research and viability | Jaime Brice | 20/09/22 | 08/10/22 | 18 | 100 %
1.3 | Research report (biblio) | Jaime Brice | 20/09/22 | 08/10/22 | 18 | 100 %
1.4 | Mass estimation | Jaime | 04/10/22 | 08/10/22 | 4 | 100 %
1.5 | Gantt diagram | Brice | 04/10/22 | 08/10/22 | 4 | 100 %

### 2 Modelisations

2.1 | Frame | Jaime | 10/10/22 | | 0 | 0 %
2.2 | Wheels | Brice | 10/10/22 | | 0 | 0 %
2.3 | Drill and auger | Brice | | | 0 | 0 %
2.4 | Rake | Jaime | | | 0 | 0 %
2.5 | Water and Seed Reservoir | Brice | | | 0 | 0 %
2.6 | Sensor connections, cards... | Jaime | | | 0 | 0 %
2.7 | Modelisations Assembly | Jaime Brice | | | 0 | 0 %

### 3 Machinery

3.1 | Robot Manufacturing | Jaime Brice | | | 0 | 0 %
3.2 | Sensor connections, cards... | Jaime Brice | | | 0 | 0 %

### 4 Code

4.1 | Sensors | Jaime Brice | | | 0 | 0 %
4.2 | Reaction to sensor results | Jaime Brice | | | 0 | 0 %
