jaimealbapastor/autonomous-gardener/Reports/Jaime/session08.md

***[<< previous session](session07.md) | [next session >>](session09.md)***

# Session 8

This session's activity was to redesign the main pivot's piece.  

I wished to use the Trellis method to remove useless material.
By doing this, impression time and weight will be decreased while maintaining the same resistance to forces.  

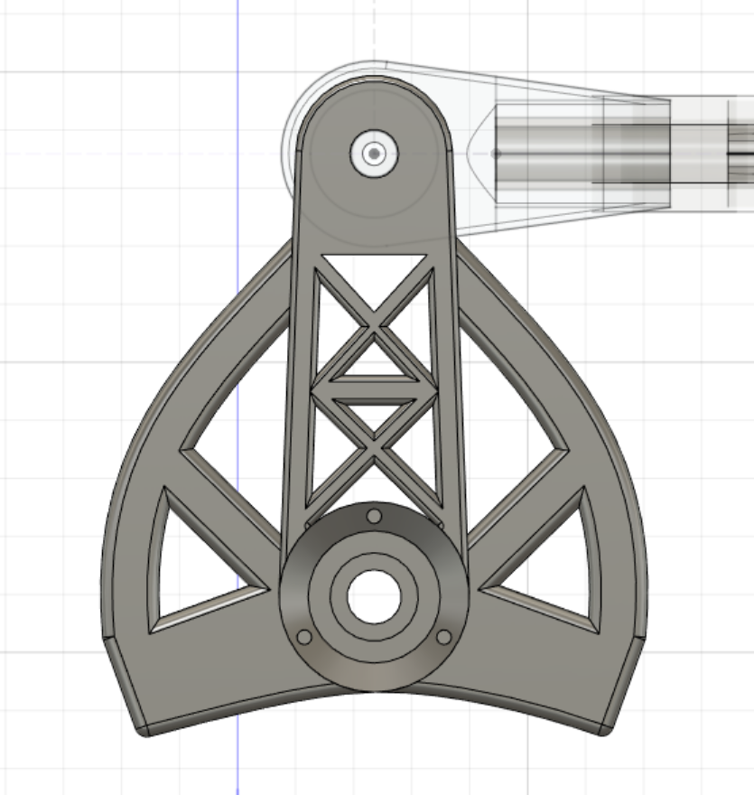
[picture p213: Documentation/Images/main_pivot_9.png]
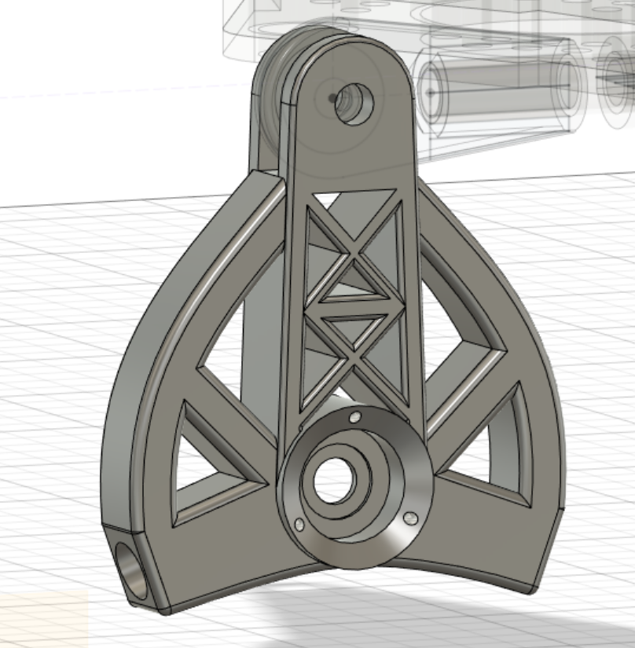
[picture p214: Documentation/Images/main_pivot_10.png]
|||
|:---:|:---:|

I emailed our mechanical teacher over the weekend to receive advice. During the session, he stopped by to visit me, and we talked about several things to do better at:

- First, despite being fashionable, the curved area offers no advantages for managing moments of force.
- Next, the line joining the outside ones should point toward the axis's center.
- Finally, a single cross can replace the two central crosses. For the kinds of forces used in the piece, this structure is adequate.

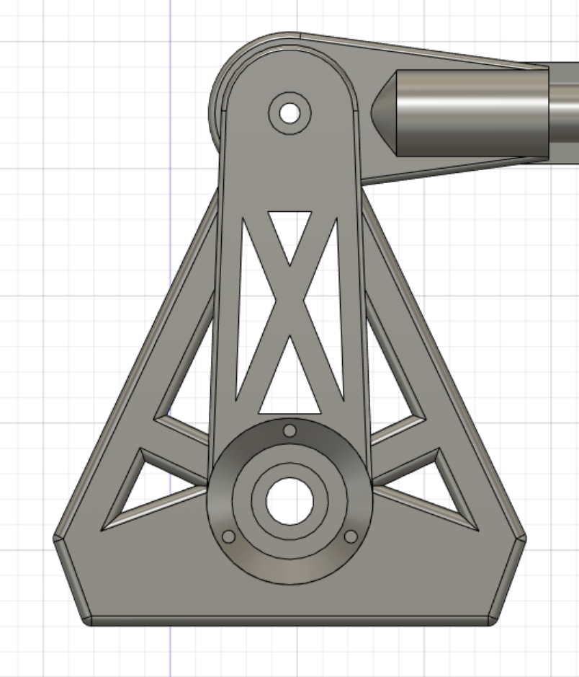
[picture p215: Documentation/Images/main_pivot_13.png]
|||
|:---:|:---:|

The final result of the piece:

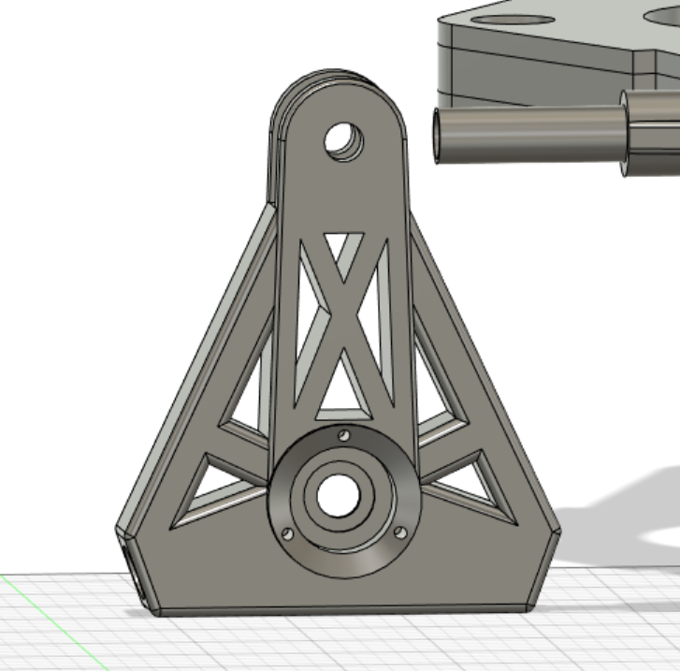
[picture p216: Documentation/Images/main_pivot_11.png]
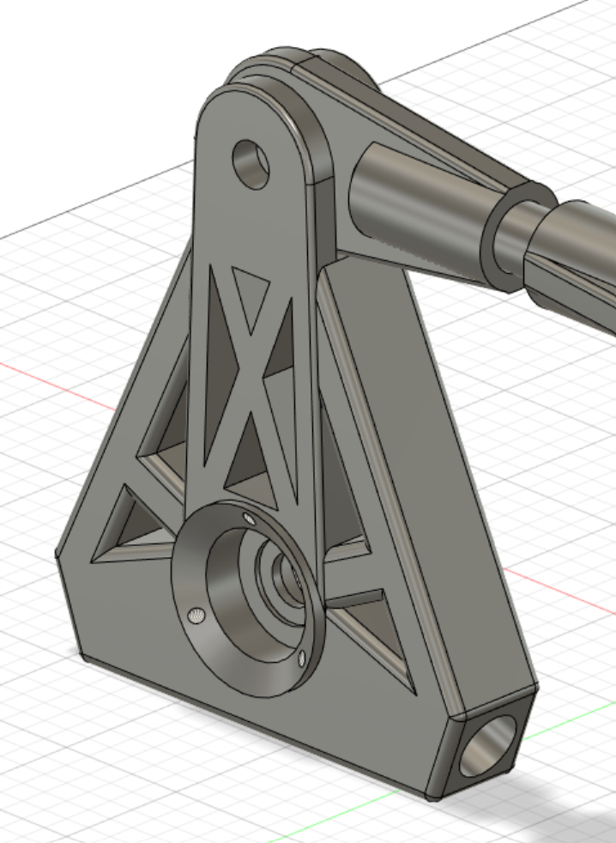
[picture p217: Documentation/Images/main_pivot_12.png]
|||
|:---:|:---:|

At the end of the session I started the 3d impression of the piece.

***[<< previous session](session07.md) | [next session >>](session09.md)***
