jaimealbapastor/autonomous-gardener/Reports/Brice/Séance 17.md

## Rapports de séance Brice Mabille

- 21/03/2023 : Setup du projet GitHub partagé

# Séance 17

During this session, I continued the electronics with Jaime and I adapt the codes.

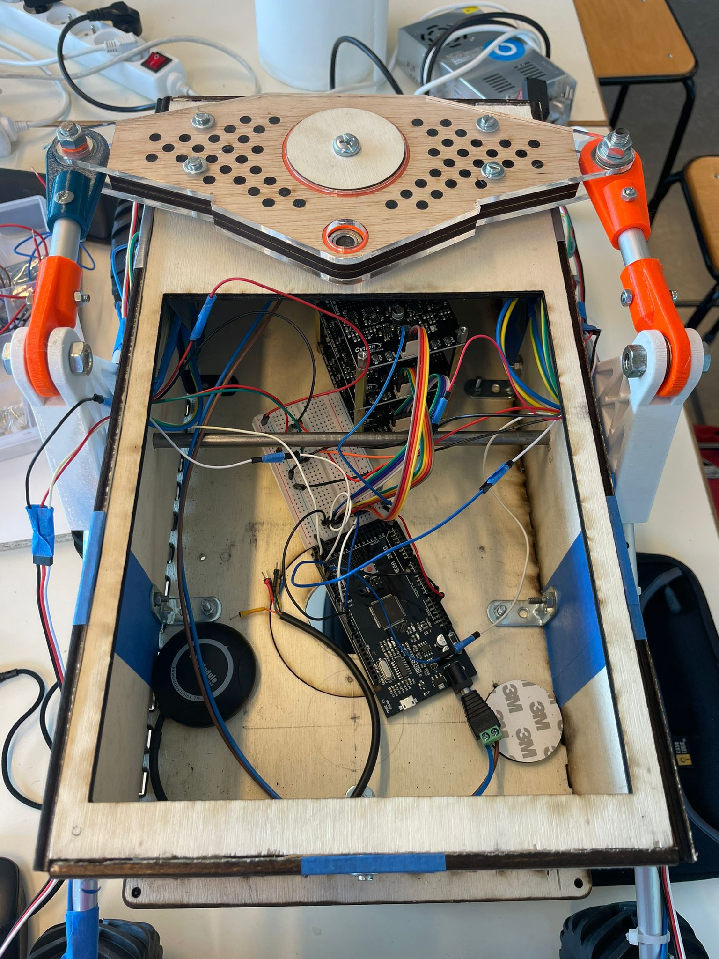
[picture p218: Documentation/Images/Electronics1.jpeg]


For the next session, I will work on the GPS Module.
