jaimealbapastor/autonomous-gardener/Documentation/Images/bogie_pivot_4.jpg

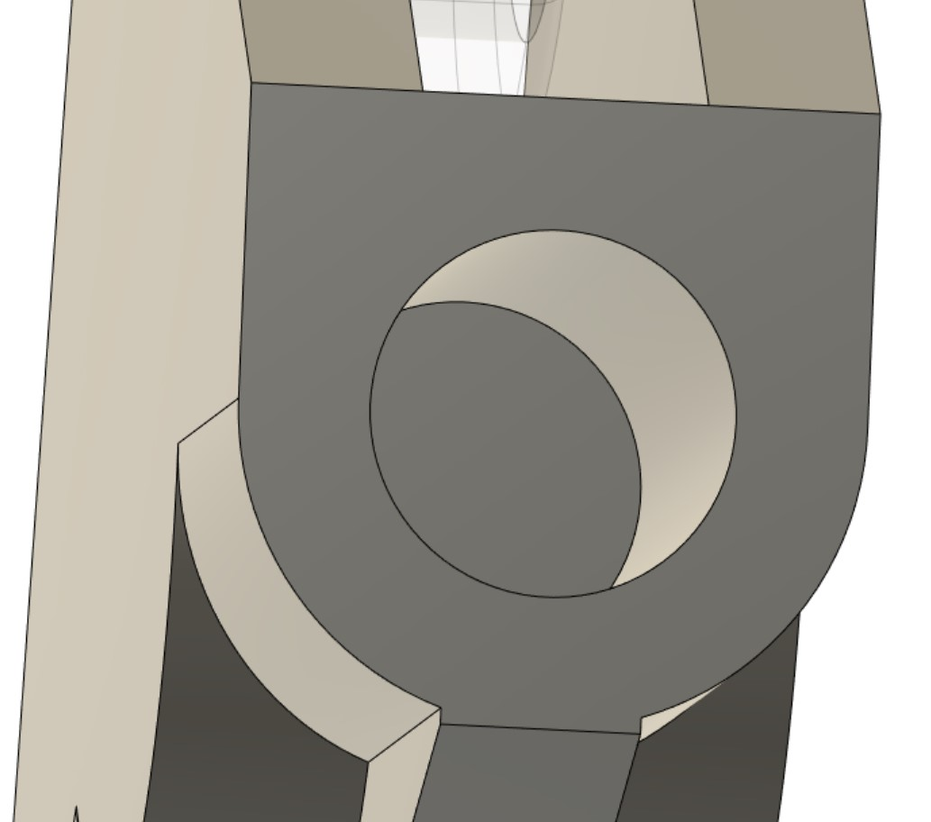
Documentation/Images/bogie_pivot_4.jpg
