jaimealbapastor/autonomous-gardener/Documentation/Images/branch_sketch2.png

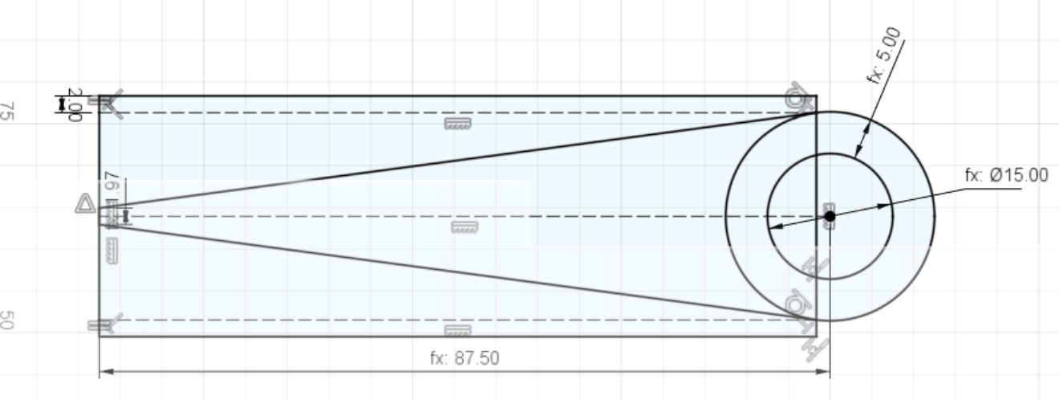
Documentation/Images/branch_sketch2.png
