jaimealbapastor/autonomous-gardener/Documentation/Images/cables5.png

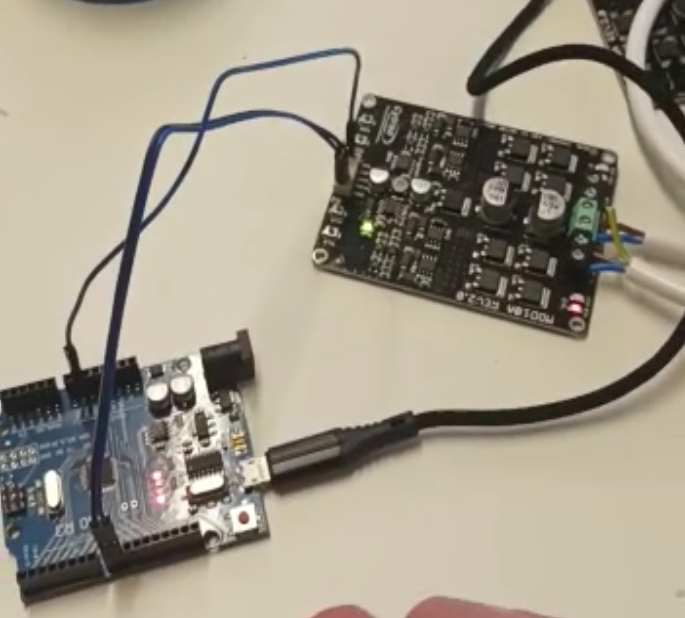
Documentation/Images/cables5.png
