jaimealbapastor/autonomous-gardener/Documentation/Images/differential_model_1.jpg

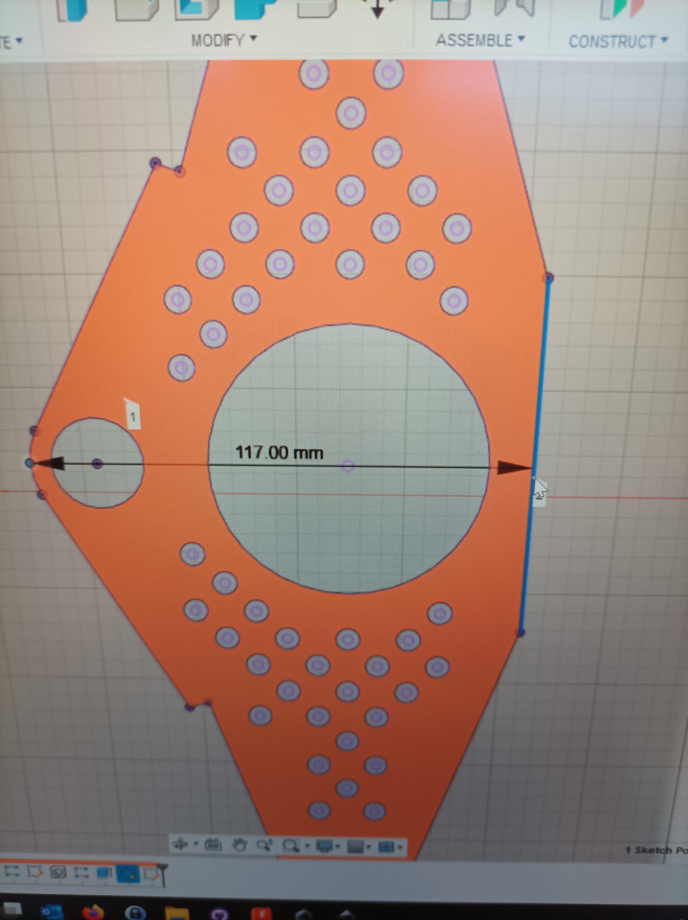
Documentation/Images/differential_model_1.jpg
