jaimealbapastor/autonomous-gardener/Documentation/Images/differential_model_2.jpg

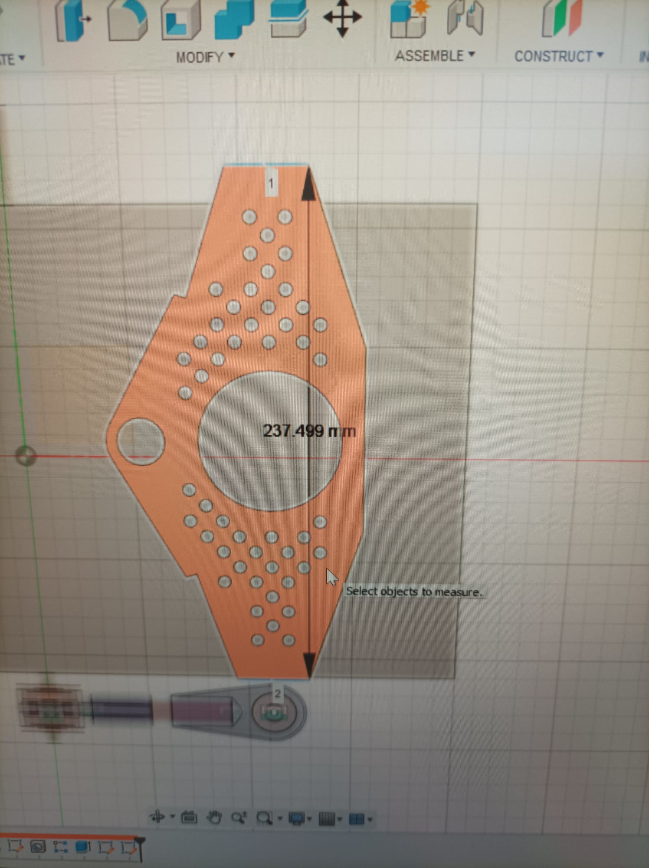
Documentation/Images/differential_model_2.jpg
