jaimealbapastor/autonomous-gardener/Documentation/Images/finished2.jpg

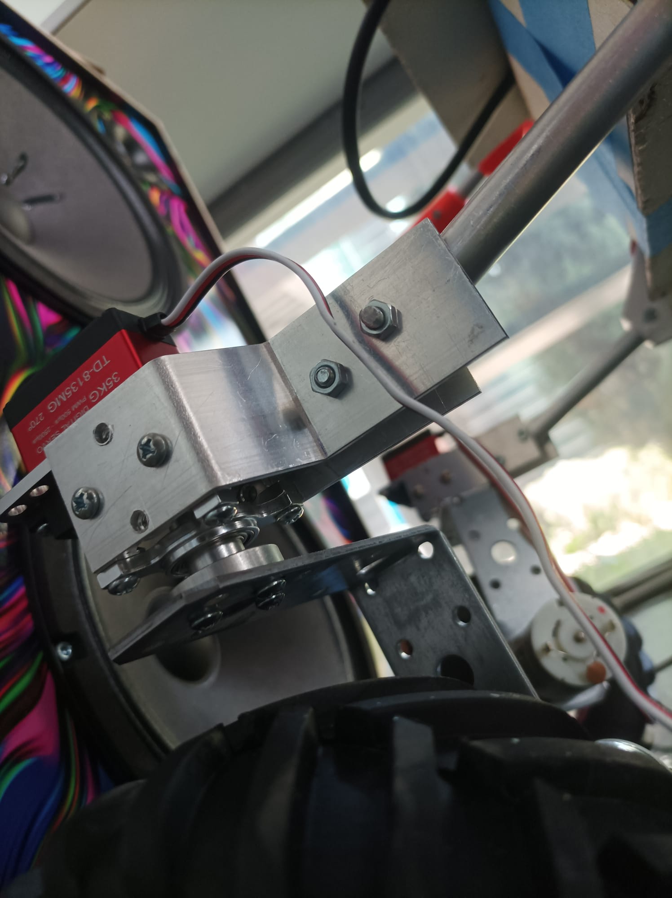
Documentation/Images/finished2.jpg
