jaimealbapastor/autonomous-gardener/Documentation/Images/finished3.jpg

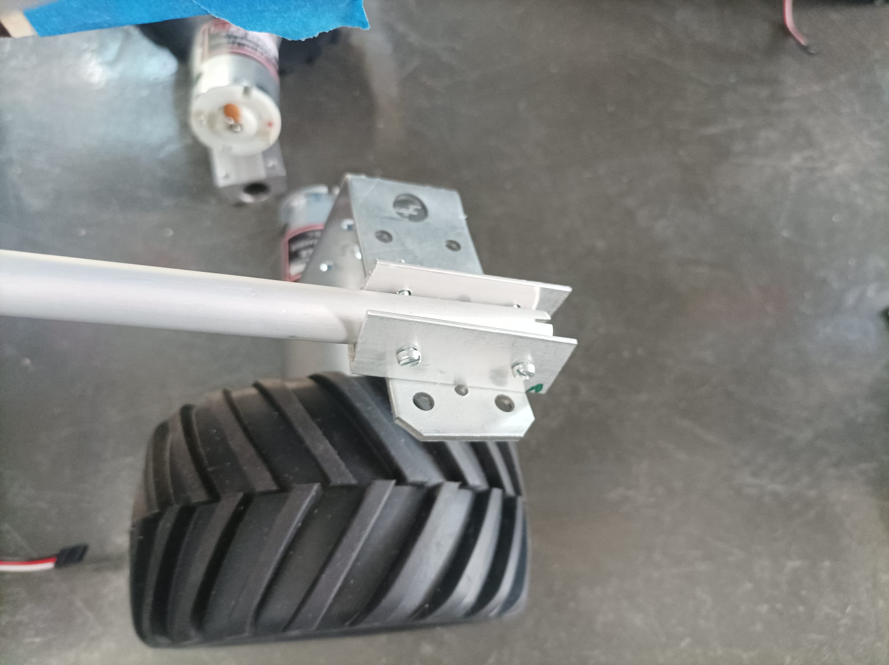
Documentation/Images/finished3.jpg
