jaimealbapastor/autonomous-gardener/Documentation/Images/finished5.jpg

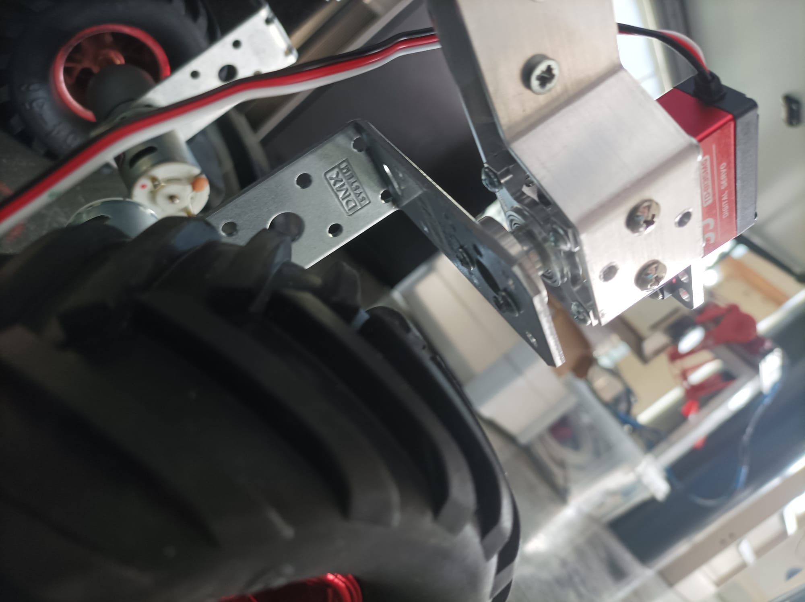
Documentation/Images/finished5.jpg
