jaimealbapastor/autonomous-gardener/Documentation/Images/finished6.jpg

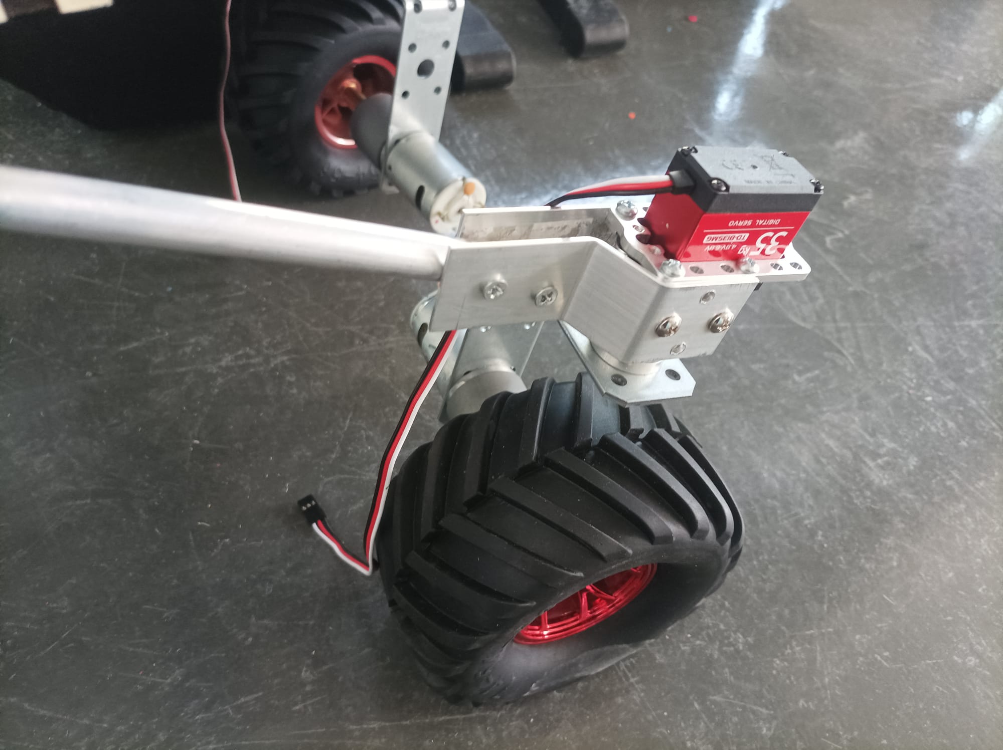
Documentation/Images/finished6.jpg
