jaimealbapastor/autonomous-gardener/Documentation/Images/full_modelization.png

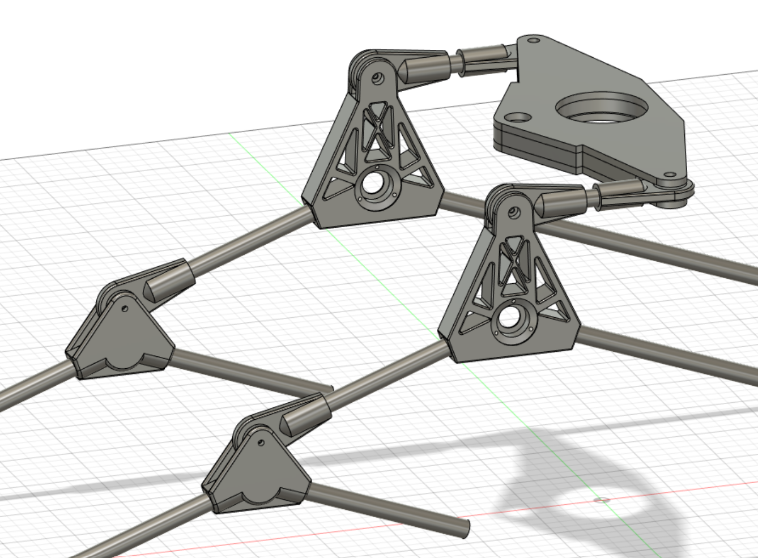
Documentation/Images/full_modelization.png
