jaimealbapastor/autonomous-gardener/Documentation/Images/marsRover2020.png

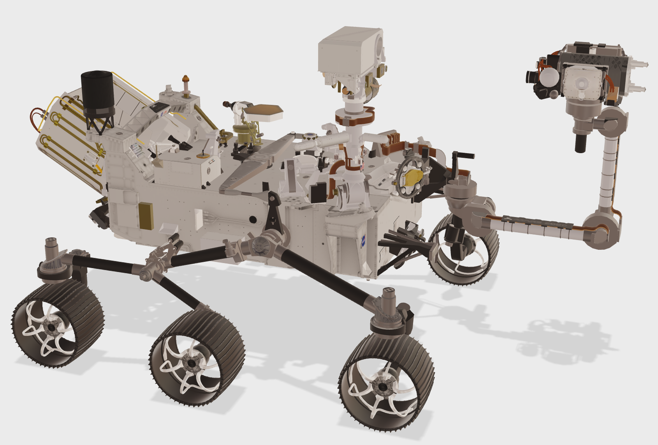
Documentation/Images/marsRover2020.png
