jaimealbapastor/autonomous-gardener/Documentation/Images/session17_5.jpg

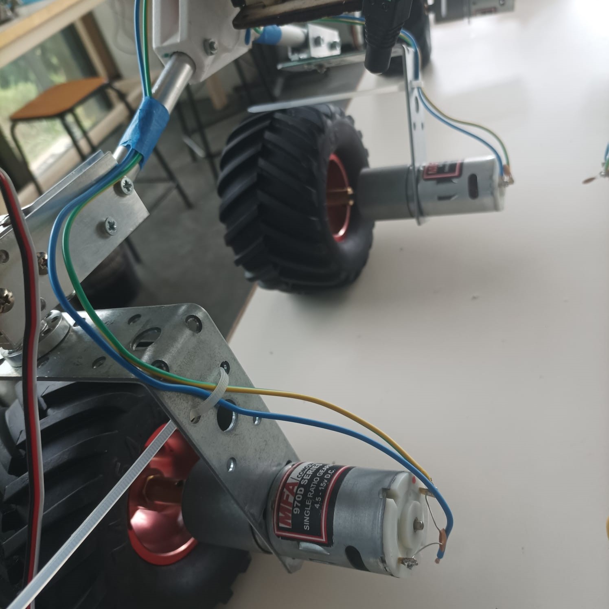
Documentation/Images/session17_5.jpg
