jaimealbapastor/autonomous-gardener/Documentation/Images/session17_12.jpg

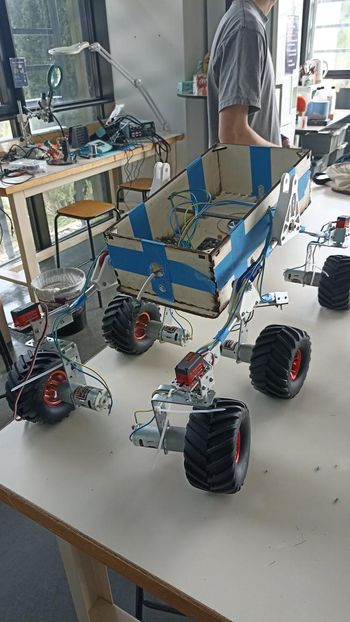
Documentation/Images/session17_12.jpg
