jaimealbapastor/autonomous-gardener/Documentation/Images/session21_2.png

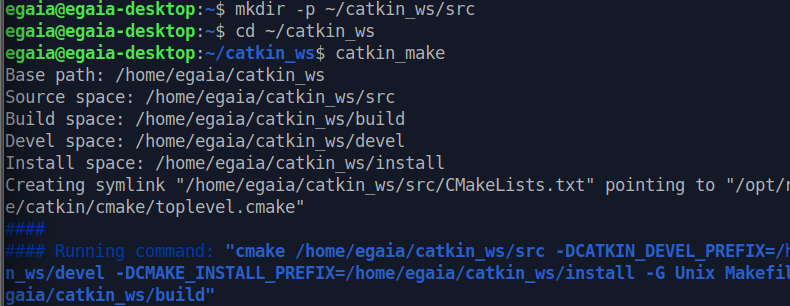
Documentation/Images/session21_2.png
