jaimealbapastor/autonomous-gardener/Documentation/Images/session21_3.png

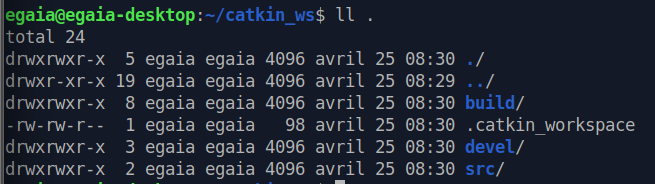
Documentation/Images/session21_3.png
