jaimealbapastor/autonomous-gardener/Documentation/Images/session21_6.png

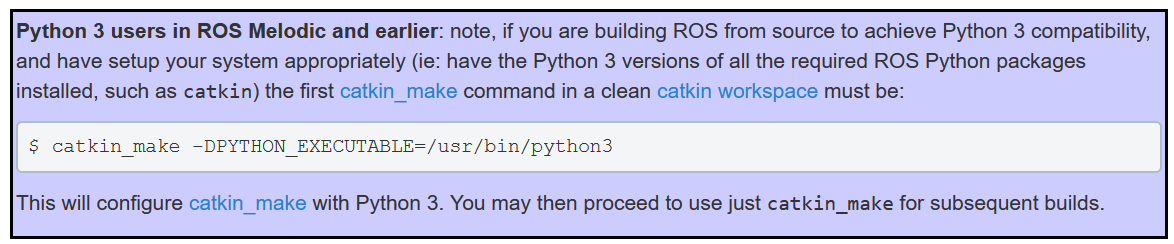
Documentation/Images/session21_6.png
