jaimealbapastor/autonomous-gardener/Code/tests/Movement/README.md

# Movement class, aka 'Wheels'

This class is responsible for the simultaneous control of the 6 motors.
It has still not have been finished but this structure will allow us to control every single movement in a simple way.

The file [Movement.ino](./Movement.ino) is a test.
