jaimealbapastor/autonomous-gardener/Documentation/Material/Motors.pdf

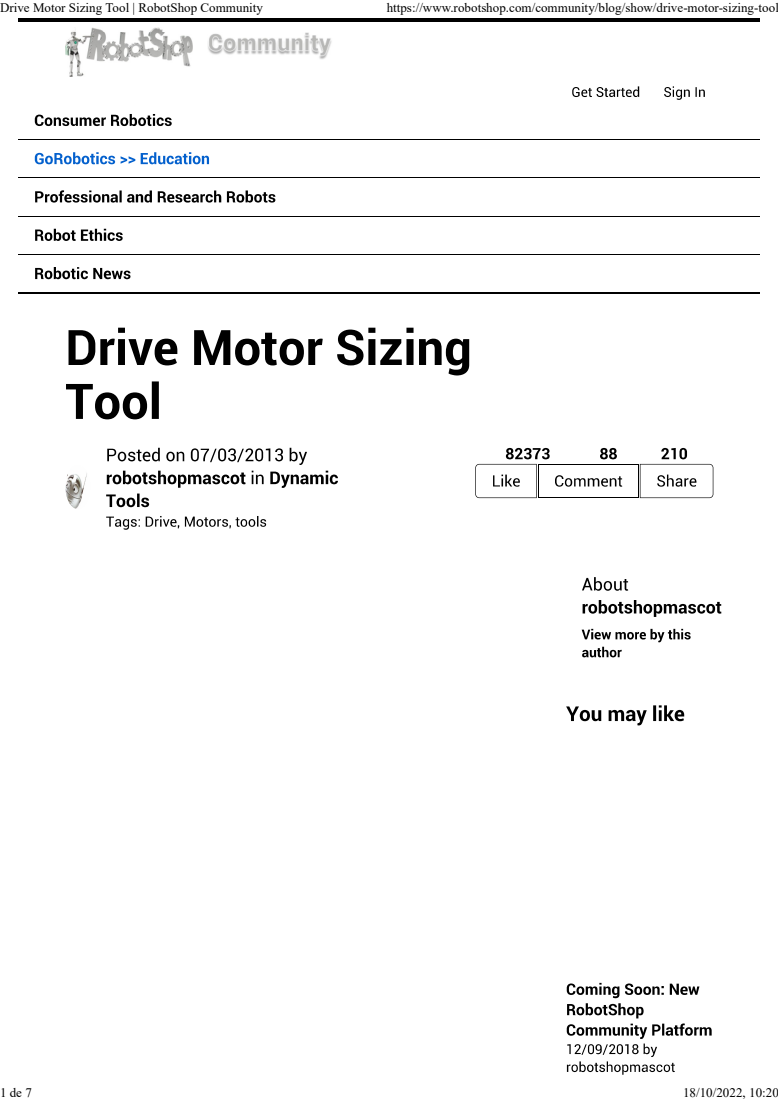
[picture p235: page 1]
Drive Motor Sizing Tool | RobotShop Community; https://www.robotshop.com/community/blog/show/drive-motor-sizing-tool

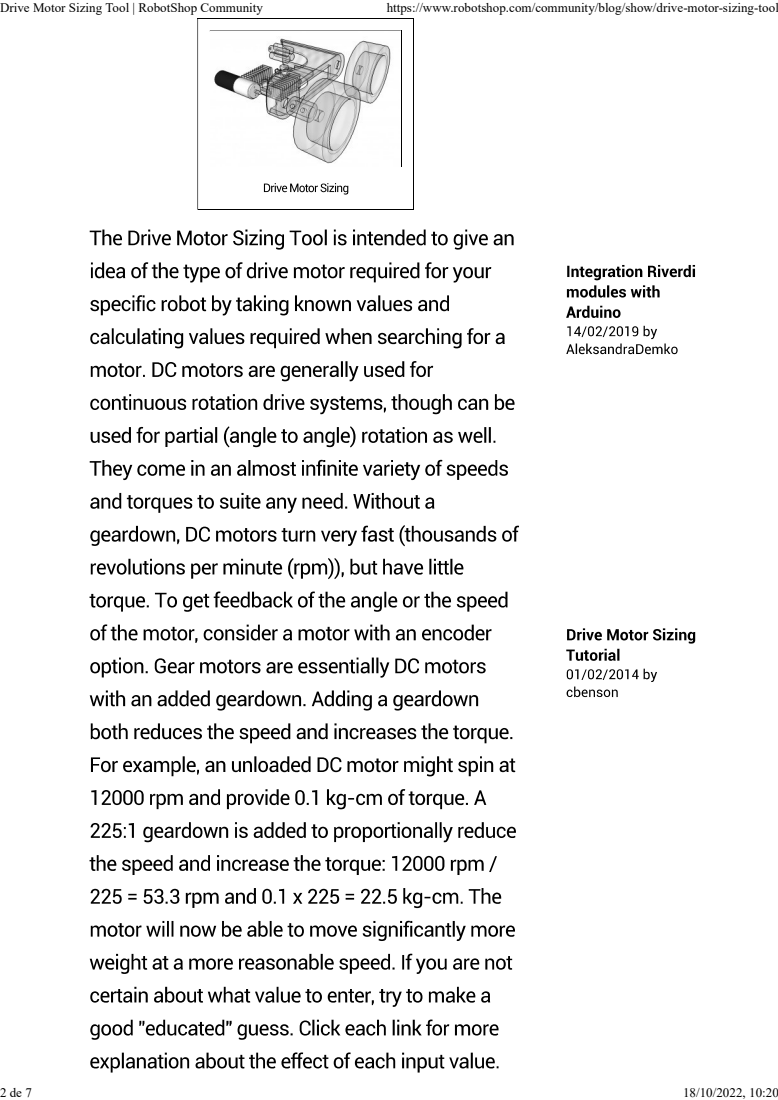
[picture p236: page 2]

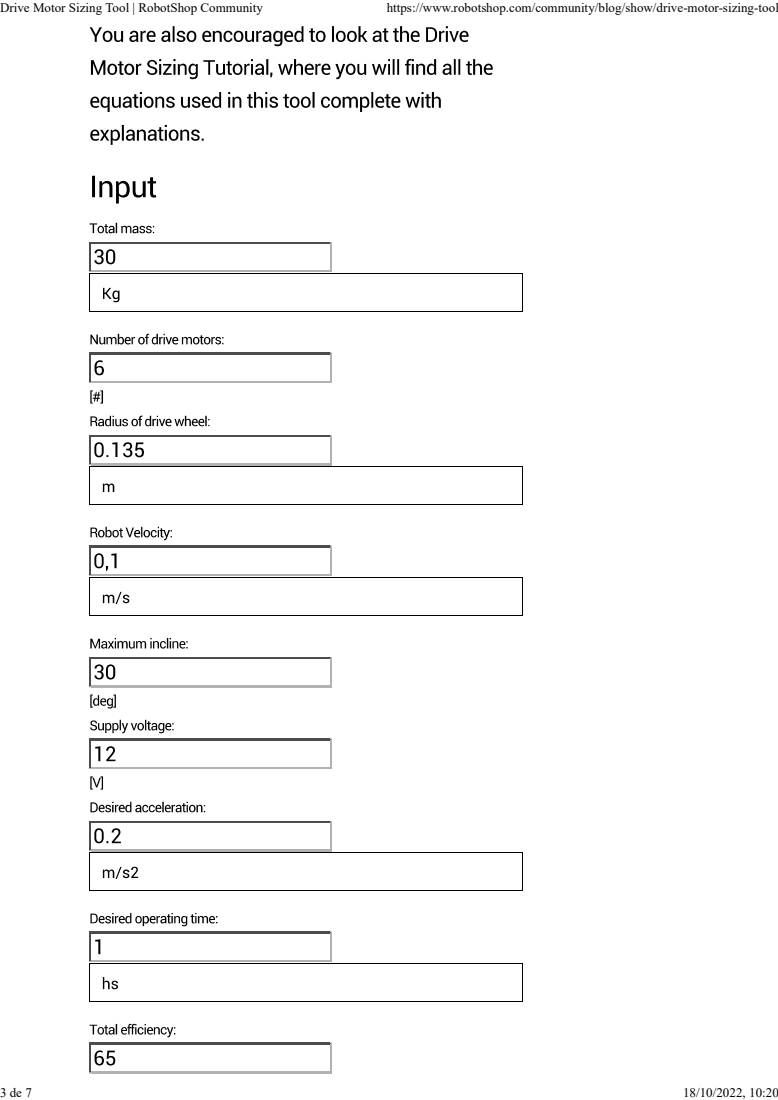
[picture p237: page 3]

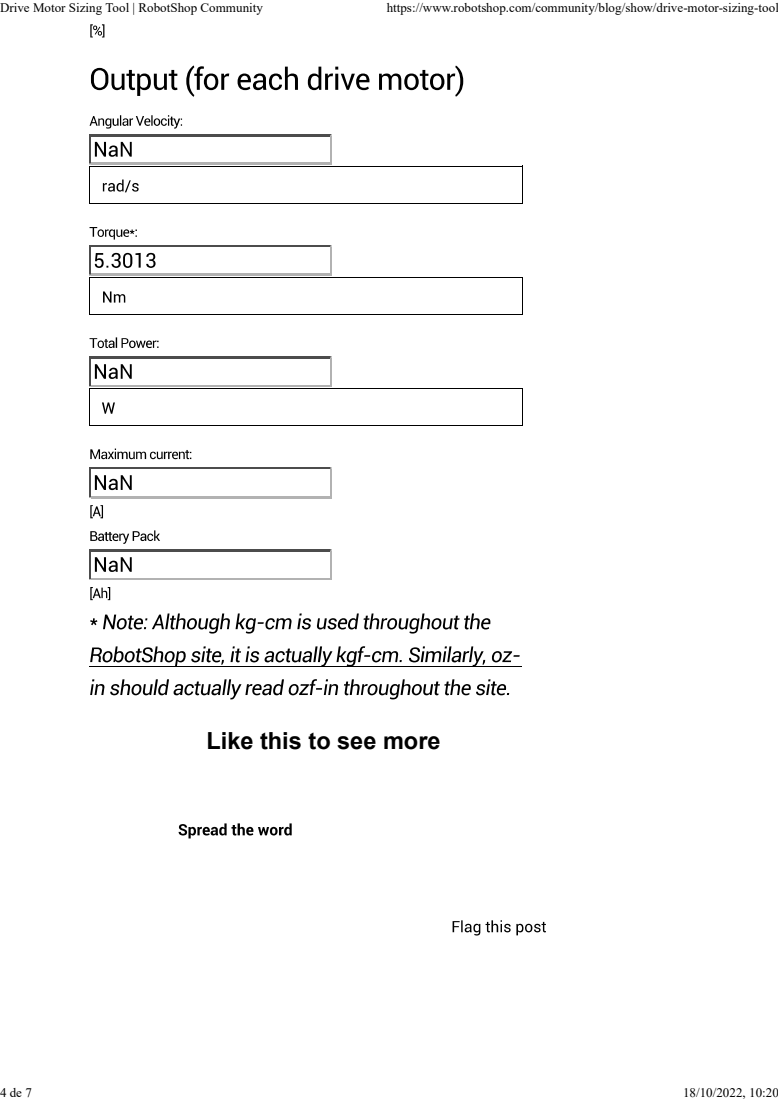
[picture p238: page 4]

Like this to see more
