jaimealbapastor/autonomous-gardener/Documentation/logic-code.pdf

# MOVING TO A CLOSE POINT

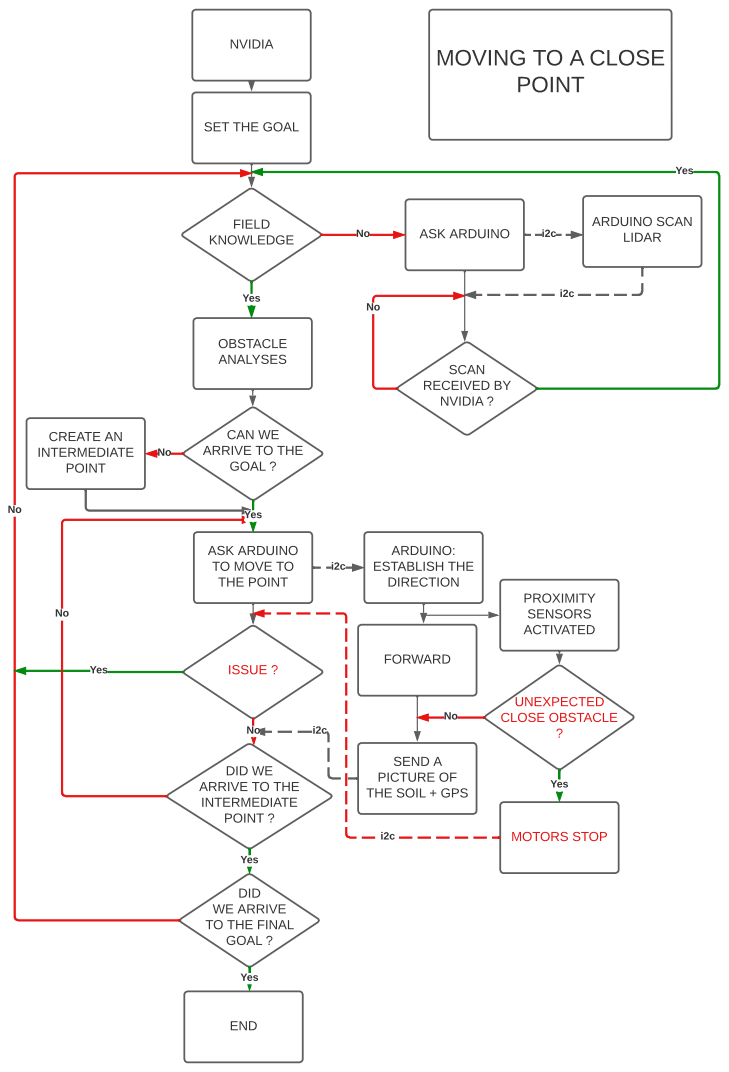
[picture p239: page 1]
CREATE AN INTERMEDIATE POINT; NVIDIA; OBSTACLE ANALYSES; FIELD KNOWLEDGE; ISSUE ?; END; ASK ARDUINO; ARDUINO SCAN LIDAR; ARDUINO: ESTABLISH THE DIRECTION; FORWARD; PROXIMITY SENSORS ACTIVATED; MOTORS STOP; UNEXPECTED CLOSE OBSTACLE ?; SCAN RECEIVED BY NVIDIA ?; Yes

SET THE GOAL

CAN WE
ARRIVE TO THE
GOAL ?

ASK ARDUINO
TO MOVE TO
THE POINT

SEND A
PICTURE OF
THE SOIL + GPS

DID WE
INTERMEDIATE
POINT ?

DID
WE ARRIVE
TO THE FINAL
