jaimealbapastor/autonomous-gardener/(commit log)

2023-02-28 drill code start
2023-05-03 wheelController class upgrade
2023-05-07 class drill
